abbottsteve/LoRaWAN-ISAC-868MHz/docs/ISAC_868_GitHub_Social_Preview_1280x640.png

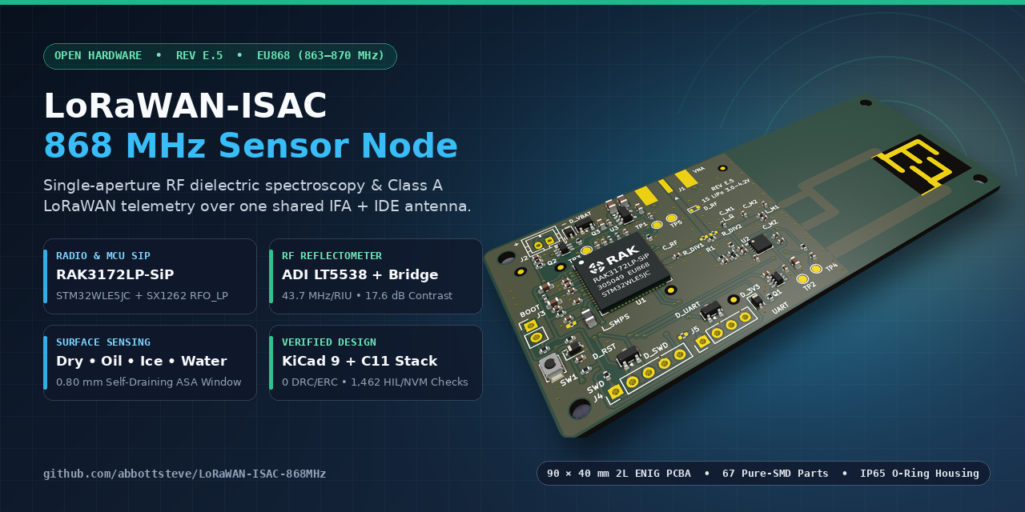
docs/ISAC_868_GitHub_Social_Preview_1280x640.png
