abbottsteve/LoRaWAN-ISAC-868MHz/docs/ISAC_868_System_BoxBuild_BOM.csv

Item | Assembly_Level | Part_Ref | Qty_OptionA_Slim_LiPo | Qty_OptionB_Stepped_LiSOCl2 | Category | Description | Specifications_And_Dimensions | Cold_Temp_Rating | Realistic_Field_Runtime | MPN | Manufacturer | Primary_Sourcing | Verified_Alternates | Assembly_And_Polarity_Notes
1 | Sub-Assembly | PCBA-01 | 1 | 1 | 100% Pure-SMD PCBA | Populated & Tested ISAC 868 MHz Rev E.5 Pure-SMD PCBA | 90.0 x 40.0 x 1.60 mm (+0.03/-0.10 mm), 2L FR-4 IPC-4552 ENIG (2-3 uin Au), Green LPI (>= 0.10 mm dams), 67 populated pure-SMD refs on ISAC_868_Turnkey_CPL_Top.csv (0 THT parts) + 10 DNP refs (J1/J2/J3/J4/J5/C_SMPS3/D_RF/R_DIV1/R_DIV2/R_VUART) per fab/bom/ISAC_868_Turnkey_BOM.csv | -40 C to +85 C | N/A (1.74 uA STOP2 sleep) | ISAC-868-PCBA-REVE5 | PCBWay Turnkey | fab/ISAC_868_RevE5_PCBWay_Turnkey.zip | JLCPCB / MacroFab Turnkey PCBA | J2 is DNP on the sealed field SKU: solder 24-26 AWG silicone battery leads directly from B.Cu (-1.60 mm) upward into J2 bare-ENIG PTH barrels: Pad 1 Square (East @ X_gbr=10.90, Y_gbr=36.15, '-' on F.SilkS & B.SilkS) = BLACK (GND), Pad 2 Round (West @ X_gbr=8.90, '+' on F.SilkS & B.SilkS) = RED (+VBAT_RAW 3.0-4.2V 1S LiPo / 3.6V Li-SOCl2 [4.35V DC MAX; NO 5V PSU]); Q3 = AO3401A ideal-diode PMOS RPP (< 6 mV drop). Factory program & 2-point calibrate via bare ENIG pogo pads on J3/J4/J5 before lid closure.
2 | Box-Build (Option A) | BAT1-OPTA-LIPO | 1 | 0 | Option A Battery (Slim Base Tray) | 302535 (or 352535) 3.7 V 300 mAh Low-Temp LiPo Pouch w/ PCM & 26 AWG Silicone Wire Leads | 3.0 x 25.0 x 35.0 mm (leaves 1.06 mm Z margin above 0.50 mm VHB inside 36.0 x 25.8 x 4.56 mm pocket; 352535 3.5 x 25.0 x 35.0 mm leaves 0.56 mm Z margin) | -20 C (standard LiPo) / -40 C (Grepow LT-LiPo) | ~2.5-3.5 years (limited by LiPo self-discharge; ~6 yrs raw Coulombic @ 4.5 uA avg) | GRP302535-3.7V-300mAh-LT | Grepow | Grepow / Authorized LiPo Distributor | PKCELL LP352535 (3.5x25x35 mm 350mAh); EEMB LP302535 (3.0x25x35 mm 250-300mAh); Adafruit 1S LiPo (trim plug one wire at a time!) | DIRECT SOLDER TO J2 BARE-ENIG PTH PADS (cut factory plug ONE WIRE AT A TIME to prevent shorting!): Pad 1 Square (East @ X_gbr=10.90, '-') = BLACK (GND), Pad 2 Round (West @ X_gbr=8.90, '+') = RED (+VBAT_RAW); Q3 AO3401A blocks reverse current safely.
3 | Box-Build (Option B) | BAT1-OPTB-LISOCL2 | 0 | 1 | Option B Battery (10-Year Sub-Zero Field Base Tray) | 2/3 AA 3.6 V 1300 mAh Spiral-Wound High-Pulse Li-SOCl2 Cell w/ Insulated Wire Leads | Dia 14.5 x 33.5 mm; 3.6 V nominal; 150 mA cont / 300 mA pulse; <1%/yr self-discharge; UN38.3 certified | -55 C to +85 C | 10+ years (~26 yrs Coulombic @ 15-min SF7; <1%/yr self-discharge) | ER14335M/W | Fanso | Authorized Battery Distributor / Fanso / Mouser | Eve Energy ER14335SPC (1300 mAh spiral); Tadiran TLP-93111 / TLH-5955; Saft LS 14250 (1/2 AA w/ foam spacer) | PRIMARY 10-YR SUB-ZERO ICE/FROST CELL (Q3 AO3401A ideal-diode RPP + VBAT-fed Q1 TPS22919DCKR + 104 uF bulk bank sustains LT5538 >= 3.00 V and 3.0V TCXO down to -40 C). Nests in 38.8 x 15.2 x 15.5 mm cradle (X=8.6..47.4 < 50 mm); solder leads directly to J2 from B.Cu. NON-RECHARGEABLE; ship per UN38.3.
4 | Box-Build | STR-RTV-3145 | 1 | 1 | Direct-Solder Wire Strain Relief | Neutral-Cure (Alkoxy) Electronics-Grade RTV Silicone Adhesive + 24-26 AWG Silicone Service-Loop Sleeving | Non-corrosive MIL-A-46146 neutral-cure RTV silicone (NEVER acetic-acid cure!) applied at B.Cu J2 wire exit; 55-65 mm 26 AWG silicone wire service loop routed in -6.16 mm under-PCB relief channel (X=7.4..15.0, Y=31.5..37.65 mm) | -55 C to +200 C | 10+ years | DOWSIL-3145-CLEAR | Dow | DigiKey / Mouser / Authorized Distributor | Momentive RTV162 (MIL-A-46146); Henkel Loctite SI 595CL neutral-cure; 3M Scotch-Weld DP100 | Insert stripped/tinned leads upward from B.Cu (-1.60 mm) into J2 Ø0.75 mm PTH barrels (Pad 1 Square=BLACK GND, Pad 2 Round=RED +VBAT_RAW), solder per IPC-A-610 Class 3 (>=75% barrel fill, trim top fillet <= +1.5 mm), and anchor lead insulation to B.Cu mask with neutral-cure RTV.
5 | Box-Build | PAD-VHB | 1 | 1 | Battery Retention Tape | Die-Cut Double-Sided Acrylic Foam Mounting Strip | 12.0 x 30.0 x 0.50 mm, viscoelastic shock/vibration damper, 100% non-metallic | -40 C to +90 C | 10+ years | VHB-4905-12X30 | 3M | DigiKey / Mouser / McMaster-Carr | 3M VHB 5925 (0.64 mm black); Tesa ACXplus 7063 | Adhere Option A LiPo or Option B ER14335M inside X < 49 mm pocket/cradle so zero rattle occurs; NEVER place foam tape or wires in X >= 50 mm antenna bay.
6 | Box-Build | ADH-WIN-467MP | 1 | 1 | Sensing Window Optical/RF Bond | Void-Free 25 um High-Performance Acrylic Transfer Adhesive Die-Cut Preform | 12.00 x 12.55 x 0.025 mm (25 um / 1.0 mil 200MP acrylic), er ~ 2.8, zero carrier film | -40 C to +149 C | 10+ years | 467MP-12X12.55 | 3M | DigiKey / Mouser / 3M Preferred Converter | 3M 468MP (50 um); Tesa 4972 (48 um) | Bond 0.80 mm ASA/PETG open-East sensing window boss (X=74.60..86.60, Y=7.65..20.20 mm) directly onto bare-ENIG AE1 comb inside continuous [73.40..87.80]x[6.65..20.80] mm F.Mask opening with roller pressure to guarantee 0.000 mm air gap across -40..+85 C.
7 | Box-Build | ENC-LID | 1 | 1 | 3D-Printed Uniform-Flat Waterproof Lid | 100% Uniform-Flat-Roof Waterproof Upper Lid (z_top = +8.50 mm) w/ Open-East Self-Draining 0.80 mm UV-Stabilized ASA Sensing Deck & Compliant -1.44 mm Face-Seal Skirt | 95.7 x 45.7 x 9.94 mm uniform height (z = -1.44..+8.50 mm; zero connector domes or PCB-bay roof slots; 4 corner M2.5 shafts sealed by captive EPDM washers); UV-stabilized ASA (outdoor default, Tg ~ 105 C; indoor alt: PETG, Tg ~ 82 C — NEVER PLA) + clear UV-acrylic / polyurethane conformal seal coat; 0.16 mm layers (5 concentric solid layers = 0.80 mm window); 0.00 mm East dam lip | -40 C to +85 C (ASA) | 10+ years | ISAC_868_Lid_0p80mm_Window.stl | Custom CAD (gen_enclosure.py) | PCBWay 3D Printing (UV-Stabilized ASA / MJF PA12) / In-House FDM | Polymaker PolyLite ASA; HP MJF PA12 w/ Vapor-Smooth Seal; Prusament ASA | Shared 100% uniform flat waterproof upper lid for BOTH Option A and Option B! Zero PCB-bay roof slots or connector bumps (J1..J5 all DNP); +0.16 mm compliant skirt gap prevents FR-4 thickness tolerance hard-stop; open-East self-draining 0.80 mm runoff deck across X=74.60..92.85 mm eliminates stagnant rain/meltwater pooling. Verify 0.80 +/- 0.02 mm window thickness with micrometer.
8 | Box-Build (Option A) | ENC-BASE-OPTA | 1 | 0 | Option A Slim Base Tray | Symmetric Slim Base Tray w/ Continuous 360-Deg 1.80x0.76 mm Parker ORD 5700 O-Ring Groove, Under-PCB J2 Wire Relief & 302535/352535 LiPo Pocket | 95.7 x 45.7 x 6.0 mm (16.10 mm uniform closed enclosure height!); UV-stabilized ASA / MJF PA12; 36.0 x 25.8 x 4.56 mm LiPo pocket + -6.16 mm J2 wire-relief channel + 4.00 mm unloaded IFA air cavity | -40 C to +85 C (ASA) | 10+ years | ISAC_868_Base_Tray.stl | Custom CAD (gen_enclosure.py) | PCBWay 3D Printing (UV-Stabilized ASA / MJF PA12) / In-House FDM | Polymaker PolyLite ASA; HP MJF PA12; Prusament ASA / PETG | OPTION A SLIM TRAY. Symmetric 360-deg unbroken 1.80 x 0.76 mm Parker face-seal O-ring groove (+0.16 mm compliant lid gap = 0.92 mm compressed gland: 23.3% squeeze, 68.3% <= 85% nominal fill, 82.7% <= 85% at 1.44 mm thin PCB); positively locates 302535/352535 LiPo and routes soldered leads underneath B.Cu inside X < 50 mm.
9 | Box-Build (Option B) | ENC-BASE-OPTB | 0 | 1 | Option B Stepped Field Base Tray | Symmetric Stepped Dual-Fit Field Battery-Bay Base Tray w/ Continuous 360-Deg 1.80x0.76 mm Parker O-Ring Groove (2/3 AA ER14335M + 302535 Shelves) | 95.7 x 45.7 x 17.5 mm (total closed node = 27.60 mm over battery pod, 16.10 mm uniform flat over electronics & antenna); UV-stabilized ASA / MJF PA12; 38.8 x 15.2 x 15.5 mm 2/3 AA cradle under X < 50 mm | -40 C to +85 C (ASA) | 10+ years | ISAC_868_Base_Tray_Battery.stl | Custom CAD (gen_enclosure.py) | PCBWay 3D Printing (UV-Stabilized ASA / MJF PA12) / In-House FDM | Polymaker PolyLite ASA; HP MJF PA12; Prusament ASA / PETG | OPTION B OUTDOOR TRAY. Cradles 2/3 AA ER14335M (or 302535/352535 LiPo on -6.16 mm shelves) while keeping 4.00 mm unloaded air pocket under 866.5 MHz IFA.
10 | Box-Build | HW-SCR-M25 | 4 | 4 | Non-Metallic Fasteners | Nylon 6/6 Pan-Head Phillips Machine Screw, M2.5 x 22 mm | M2.5 x 0.45 mm thread, 22.0 mm length, Polyamide 6.6 (PA66), 100% non-magnetic / RF-transparent (fits Dia 2.70 mm ISO 273 medium-fit H1..H4; +2.30 mm full nut thread engagement across 16.10 mm shell + 2x0.80 mm EPDM washers + 2.00 mm nut) | -40 C to +85 C | 10+ years | 9652522 | Wurth Elektronik / Keystone | DigiKey RPC2065-ND / Mouser / McMaster 93805A110 | Keystone 29319; Essentra M2.5x22 PA66; Bossard BN 13260 | Identical M2.5 x 22 mm screw length for BOTH Option A and Option B (+2.30 mm full nut thread protrusion beyond 2.0 mm ISO 4032 nut)! Mandatory non-metallic Nylon inside 40x40 mm antenna aperture.
11 | Box-Build | HW-WSH-M25-SEAL | 8 | 8 | Fastener Weather Sealing Washers | Captive EPDM / Nylon 6/6 Sealing Washer for M2.5 Screw Head & Nut | ID 2.6 mm x OD 5.5 mm x 0.8 mm Shore 60A EPDM / PA66 sealing washer | -40 C to +110 C | 10+ years | 95620A112 | McMaster-Carr / Essentra | McMaster 95620A112 / DigiKey / Mouser | Essentra Sealing Washer M2.5; Bulte EPDM-M2.5 | Install under all 4x M2.5 screw heads on lid exterior and 4x M2.5 hex nuts on base underside to weather-seal the corner clamping shafts.
12 | Box-Build | HW-NUT-M25 | 4 | 4 | Non-Metallic Fasteners | Nylon 6/6 Hex Nut, M2.5 (ISO 4032 / DIN 934) | M2.5 x 0.45 mm, 5.0 mm across flats, 2.0 mm height, Polyamide 6.6 (PA66) | -40 C to +85 C | 10+ years | 4702 | Keystone Electronics | DigiKey 36-4702-ND / Mouser 534-4702 | Wurth 93425; Essentra DIN934-M2.5-PA66 | Clears stepped battery pod wall on Option B (3.10 mm clearance > 2.89 mm nut corner radius) and sits flat on Option A.
13 | Box-Build | SEAL-ORING-EPDM | 1 | 1 | Continuous 360-Deg Perimeter Face-Seal | Closed-Loop Shore 50A Silicone / EPDM O-Ring (or Spliced Vulcanized Cord, 272 mm Perimeter) | Dia 1.20 mm cross-section Shore 50A Silicone / EPDM seated in continuous symmetric 1.80 x 0.76 mm Parker ORD 5700 static face-seal groove (+0.16 mm compliant lid gap = 0.92 mm gland: 23.3% vertical squeeze, 68.3% <= 85% nominal fill, 82.7% <= 85% at 1.44 mm thin PCB) | -55 C to +120 C | 10+ years | OR-SIL-1.20X86-50A | Parker / McMaster-Carr | McMaster 1187N11 / Parker Hannifin / Mouser | Parker S0604-50; Trelleborg EPDM 1.20 mm vulcanized loop | Seat continuous 360-deg loop into unbroken 1.80 x 0.76 mm base perimeter groove before torquing 4x M2.5 x 22 mm Nylon screws onto EPDM sealing washers.
14 | Bench-Optional | CAP-SMA-01 | 0 | 0 | Optional Bare-Board Bench VNA Dust Cap | Silicone / Gasketed Protective Dust Cap for Optional Bench J1 SMA Port (J1 is DNP on Enclosed Field SKU) | 1/4-36 UNS-2B female SMA cap w/ internal silicone O-ring (used only on un-enclosed bench VNA bring-up boards with J1 populated) | -55 C to +125 C | 10+ years | 132357 | Amphenol RF | DigiKey ARF1327-ND / Mouser 523-132357 | Cinch Connectivity 142-0901-901; Linx/TE CONCAP-SMA | Bench bare-PCBA VNA bring-up option only; enclosed Rev E.5 field units leave J1/J2/J3/J4/J5 DNP under the unbroken uniform-flat waterproof shell.
