abbottsteve/LoRaWAN-ISAC-868MHz/fab/bom/ISAC_868_Turnkey_BOM.csv

Item | Designators | Qty | Value | Footprint | MPN | Manufacturer | LCSC | Alternates | DNP
1 | C_BAT, C_CAPM, C_CAPP, C_INN | 4 | 1n | Capacitor_SMD:C_0402_1005Metric | GRM1555C1H102JA01D | Murata | C76947 | Samsung CL05C102JB5NNNC (C1523); Yageo CC0402JRNPO9BN102 | No
2 | C_BLK, C_RF | 2 | 100p | Capacitor_SMD:C_0402_1005Metric | GJM1555C1H101JB01D | Murata | Authorized: DigiKey/Mouser | Murata GRM1555C1H101JA01D; Samsung CL05C101JB5NNNC | No
3 | C_BULK1, C_BULK2 | 2 | 47u | Capacitor_SMD:C_0805_2012Metric | GRM21BR61A476ME15L | Murata | C124129 | Samsung CL21A476MQYNNNE; Taiyo Yuden LMK212BBJ476MG-T | No
4 | C_DET1, C_IN2, C_LPF, C_OUT2, C_Q1, C_RST, C_U1B, C_U1C, C_VREF | 9 | 100n | Capacitor_SMD:C_0402_1005Metric | GRM155R71C104KA88D | Murata | C71629 | Samsung CL05B104KO5NNNC (C1525); Yageo CC0402KRX7R7BB104 | No
5 | C_DET2, C_OUT1 | 2 | 1u | Capacitor_SMD:C_0603_1608Metric | GRM188R71E105KA12D | Murata | C86020 | Samsung CL10B105KA8NNNC; Yageo CC0603KRX7R8BB105 | No
6 | C_IN1 | 1 | 10u | Capacitor_SMD:C_0603_1608Metric | GRM188R61E106MA73D | Murata | C91606 | Samsung CL10A106MA8NRNC; Murata GRM188R61E106KA73D | No
7 | C_M1 | 1 | 3.6p | Capacitor_SMD:C_0402_1005Metric | GJM1555C1H3R6WB01D | Murata | Authorized: DigiKey/Mouser | Murata GJM1555C1H3R6BB01D (C94175); Johanson 500R07S3R6BV4T | No
8 | C_M2 | 1 | 4.3p | Capacitor_SMD:C_0402_1005Metric | GJM1555C1H4R3WB01D | Murata | Authorized: DigiKey/Mouser | Murata GJM1555C1H4R3BB01D (C94181); Johanson 500R07S4R3BV4T | No
9 | C_MZ | 1 | 0.5p | Capacitor_SMD:C_0402_1005Metric | GJM1555C1HR50WB01D | Murata | Authorized: DigiKey/Mouser | Murata GJM1555C1HR50BB01D (C181064); Johanson 500R07SR50BV4T | No
10 | C_PAV, C_RFV, C_VBAT, C_VDDA2 | 4 | 1u | Capacitor_SMD:C_0402_1005Metric | GRM155R61E105KA12D | Murata | C77009 | Samsung CL05A105KA5NQNC; Taiyo Yuden TMK105BJ105KV-F | No
11 | C_S, C_S2 | 2 | 1.0p | Capacitor_SMD:C_0402_1005Metric | GJM1555C1H1R0WB01D | Murata | C161339 | Murata GRM1555C1H1R0WA01D; Johanson 500R07S1R0AV4T | No
12 | C_SMPS1 | 1 | 4.7u | Capacitor_SMD:C_0402_1005Metric | GRM155R61A475MEAAD | Murata | C335105 | Samsung CL05A475MP5NRNC; Taiyo Yuden LMK105BJ475MV-F | No
13 | C_SMPS2 | 1 | 470n | Capacitor_SMD:C_0402_1005Metric | GRM155R71C474KA01D | Murata | C52923 | Samsung CL05B474KO5NNNC (C1621); Taiyo Yuden TMK105B7474KVHF | No
14 | C_U1A, C_VDDA1 | 2 | 4.7u | Capacitor_SMD:C_0603_1608Metric | GRM188R61E475KE11D | Murata | C90057 | Samsung CL10A475KA8NNNC; Taiyo Yuden TMK107BJ475KA-T | No
15 | D_3V3, D_RST, D_VBAT | 3 | PESD5V0S1BA | Diode_SMD:D_SOD-323 | PESD5V0S1BA,115 | Nexperia | C19224 | Nexperia PESD5V0L1BA,115 (C15847, I_RM<=50nA, SOD-323 bidir); Bourns CDSOD323-T05C (SOD-323 bidir) | No
16 | D_SWD, D_UART | 2 | PESD5V0U2BT | Package_TO_SOT_SMD:SOT-23 | PESD5V0U2BT,215 | Nexperia | Authorized: DigiKey/Mouser | Nexperia PESD5V0L2BT,215 (C15855); TI TPD2E009DBZR; ST ESDA6V1L (SOT-23 3-pin 1=IO1,2=IO2,3=GND) | No
17 | FB_PA, FB_RF, FB_VDDA | 3 | 120R@100M | Inductor_SMD:L_0402_1005Metric | BLM15AG121SN1D | Murata | C85812 | TDK MMZ1005S121CT000; Taiyo Yuden BK1005HS121-T | No
18 | FB_SMPS | 1 | 0R | Resistor_SMD:R_0402_1005Metric | RC0402JR-070RL | Yageo | C60485 | Uni-Royal 0402WGF0000TCE; Panasonic ERJ-2GE0R00X | No
19 | L_M1 | 1 | 8.2n | Inductor_SMD:L_0402_1005Metric | LQW15AN8N2G00D | Murata | Authorized: DigiKey/Mouser | Coilcraft 0402CS-8N2XGLW; Taiyo Yuden HKQ1005S8N2S-T | No
20 | L_Q | 1 | 27n | Inductor_SMD:L_0402_1005Metric | LQW15AN27NG00D | Murata | Authorized: DigiKey/Mouser | Coilcraft 0402CS-27NXGLW; Murata LQW15AN27NG80D | No
21 | L_S | 1 | 30n | Inductor_SMD:L_0402_1005Metric | LQW15AN30NG00D | Murata | Authorized: DigiKey/Mouser | Coilcraft 0402CS-30NXGLW; Murata LQW15AN30NG80D | No
22 | L_SMPS | 1 | 15u | Inductor_SMD:L_0805_2012Metric | LQH2MCN150K02L | Murata | C86089 | Murata LQM21PN150MGH (0805 15uH power inductor, Isat=300mA); TDK VLS201610HBX-150M-1 -- NEVER substitute ferrite EMI beads (MLZ2012) | No
23 | Q1 | 1 | TPS22919DCKR | Package_TO_SOT_SMD:SOT-363_SC-70-6 | TPS22919DCKR | Texas Instruments | Authorized: DigiKey/Mouser | NO SUBSTITUTION -- TI TPS22919DCKR / TPS22919QDCKRQ1 (SC-70-6 DCK pinout 1=VIN,2=GND,3=ON,4=NC,5=QOD,6=VOUT) ONLY | No
24 | Q2 | 1 | NX3008CBKS | Package_TO_SOT_SMD:SOT-363_SC-70-6 | NX3008CBKS,115 | Nexperia | C456076 | NO SUBSTITUTION -- Nexperia NX3008CBKS,115 (SOT-363 complementary N+P MOSFET, 1=S1,2=G1,3=D2,4=S2,5=G2,6=D1) ONLY | No
25 | Q3 | 1 | AO3401A | Package_TO_SOT_SMD:SOT-23 | AO3401A | Alpha & Omega | C15127 | Nexperia PMV48XP,215 (C15137); Infineon IRLML6402TRPBF (C2590); Vishay SI2301CDS-T1-GE3 (C10487) | No
26 | R1 | 1 | 8.2 (0.1%) | Resistor_SMD:R_0402_1005Metric | RT0402BRD078R2L | Yageo | Authorized: DigiKey/Mouser | Yageo RT0402DRD078R2L (±0.5%); Panasonic ERA-2AED8R2X (±0.5%) | No
27 | R2 | 1 | 681 (0.1%) | Resistor_SMD:R_0402_1005Metric | RG1005P-6810-B-T5 | Susumu | Authorized: DigiKey/Mouser | Vishay TNPW0402681RBEED; Yageo RT0402BRD07681RL | No
28 | R3 | 1 | 3.57k (0.1%) | Resistor_SMD:R_0402_1005Metric | RG1005P-3571-B-T5 | Susumu | Authorized: DigiKey/Mouser | Vishay TNPW04023K57BEED; Yageo RT0402BRD073K57L | No
29 | R_B1, R_B2 | 2 | 4.7k (0.1%) | Resistor_SMD:R_0402_1005Metric | RG1005P-472-B-T5 | Susumu | Authorized: DigiKey/Mouser | Vishay TNPW04024K70BEED; Yageo RT0402BRD074K7L | No
30 | R_BG | 1 | 470k | Resistor_SMD:R_0402_1005Metric | RC0402FR-07470KL | Yageo | C482181 | Uni-Royal 0402WGF4703TCE; Vishay CRCW0402470KFKED | No
31 | R_BHI, R_BOOT, R_RST | 3 | 10k | Resistor_SMD:R_0402_1005Metric | RC0402FR-0710KL | Yageo | C60490 | Uni-Royal 0402WGF1002TCE; Vishay CRCW040210K0FKED | No
32 | R_BPD, R_PD | 2 | 100k | Resistor_SMD:R_0402_1005Metric | RC0402FR-07100KL | Yageo | C60491 | Uni-Royal 0402WGF1003TCE; Vishay CRCW0402100KFKED | No
33 | R_LPF, R_VAPP | 2 | 1k | Resistor_SMD:R_0402_1005Metric | RC0402FR-071KL | Yageo | C106235 | Uni-Royal 0402WGF1001TCE; Vishay CRCW04021K00FKED | No
34 | R_TERM | 1 | 56 (0.1%) | Resistor_SMD:R_0402_1005Metric | RG1005P-560-B-T5 | Susumu | Authorized: DigiKey/Mouser | Vishay TNPW040256R0BEED; Yageo RT0402BRD0756RL | No
35 | SW1 | 1 | RESET | Button_Switch_SMD:SW_SPST_B3U-1000P | B3U-1000P | Omron | C231329 | Omron B3U-1000P-B (exact 3.0x2.5mm 2-pad SPST SMD land pattern) | No
36 | U1 | 1 | RAK3172LP-SiP | ISAC:RAK3172LP-SiP_LGA-73_12x12mm_P0.6mm | RAK3172LP-SIP-8-SM-NI | RAKwireless | Authorized: RAKwireless/Mouser/DigiKey | NO SUBSTITUTION -- Authorized RAKwireless SKU 305049 / Mouser 910-RAK3172LPSIP8SMN / DigiKey ONLY (EU868 RFO_LP LGA-73; DO NOT substitute RAK3172-SiP RFO_HP) | No
37 | U2 | 1 | LT5538IDD#TRPBF | ISAC:LT5538IDD_DFN-8-1EP_3x3mm_P0.5mm_EP1.65x2.38mm | LT5538IDD#TRPBF | Analog Devices | Authorized: DigiKey/Mouser | NO SUBSTITUTION -- Analog Devices LT5538IDD#TRPBF (8mm T&R, Mouser 584-LT5538IDD#TRPBF / DigiKey LT5538IDD#TRPBFCT-ND); LT5538IDD#PBF (37-pc tube, LCSC C580201 -- requires custom tube feeder) | No
38 | U3 | 1 | TPS7A0233DBVR | Package_TO_SOT_SMD:SOT-23-5 | TPS7A0233DBVR | Texas Instruments | C2873330 | NO SUBSTITUTION -- TI TPS7A0233DBVR (SOT-23-5 DBV pinout 1=IN,2=GND,3=EN,4=NC,5=OUT, Iq=25nA) ONLY | No
39 | C_SMPS3 | 1 | DNP 100n | ISAC:C_0402_1005Metric_DNP_NoPaste | GRM155R71C104KA88D | Murata | C71629 | Samsung CL05B104KO5NNNC (C1525); Yageo CC0402KRX7R7BB104 | Yes
40 | D_RF | 1 | DNP | ISAC:D_SOD-523_DNP_NoPaste | ESD9B5.0ST5G | onsemi | Authorized: DigiKey/Mouser | Nexperia PESD5V0U1BB,115 (C85364); Vishay VESD05A1B-HAF-GS08 (SOD-523 ultra-low Cd=0.5pF RF ESD) | Yes
41 | J1 | 1 | DNP SMA_VNA | ISAC:SMA_Molex_73251-1153_EdgeMount_Horizontal_HandSolder | 73251-1153 | Molex | Authorized: Mouser/DigiKey | NO SUBSTITUTION -- Molex 73251-1153 (1.60mm PCB edge-straddle SMA jack; DNP on enclosed field SKU, post-reflow hand-solder on bench VNA units) ONLY | Yes
42 | J2 | 1 | DNP 1S_BATT | Connector_JST:JST_PH_B2B-PH-K_1x02_P2.00mm_Vertical | B2B-PH-K-S | JST | C131337 | DNP on sealed field SKU -- solder 24-26 AWG silicone battery leads directly to bare ENIG PTH pads (Pad1 Square=BLACK GND, Pad2 Round=RED +VBAT_RAW); JST B2B-PH-K-S(LF)(SN) (LCSC C54911) optional for bench builds | Yes
43 | J3 | 1 | DNP BOOT | Connector_PinHeader_2.54mm:PinHeader_1x02_P2.54mm_Vertical | PZ254V-11-02P | XFCN | C492401 | Wurth 61300211121; Amphenol 68000-102HLF (DNP on sealed field SKU -- bare ENIG pogo-pin pads) | Yes
44 | J4 | 1 | DNP SWD | Connector_PinHeader_2.54mm:PinHeader_1x05_P2.54mm_Vertical | PZ254V-11-05P | XFCN | C492404 | Wurth 61300511121; Amphenol 68000-105HLF (DNP on sealed field SKU -- bare ENIG pogo-pin pads) | Yes
45 | J5 | 1 | DNP UART | Connector_PinHeader_2.54mm:PinHeader_1x04_P2.54mm_Vertical | PZ254V-11-04P | XFCN | C492403 | Wurth 61300411121; Amphenol 68000-104HLF (DNP on sealed field SKU -- bare ENIG pogo-pin pads) | Yes
46 | R_DIV1, R_DIV2, R_VUART | 3 | DNP 0R | ISAC:R_0402_1005Metric_DNP_NoPaste | RC0402JR-070RL | Yageo | C60485 | Uni-Royal 0402WGF0000TCE; Panasonic ERJ-2GE0R00X | Yes
