abbottsteve/LoRaWAN-ISAC-868MHz/fab/cpl/ISAC_868_Bench_THT_HandSolder.csv

Ref | Val | Package | FieldSKU_DNP | BodyCenter_X_mm | BodyCenter_Y_mm | Pad1_X_mm | Pad1_Y_mm | Rot_deg | AssemblyProcess
J1 | DNP SMA_VNA | SMA_Molex_73251-1153_EdgeMount_Horizontal_HandSolder | Yes | 34.5000 | 36.2675 | 34.5000 | 37.3400 | 270.0000 | DNP_FieldSKU_HandSolder_BenchVNA_PostReflow
J2 | DNP 1S_BATT | JST_PH_B2B-PH-K_1x02_P2.00mm_Vertical | Yes | 9.9000 | 36.1500 | 10.9000 | 36.1500 | 180.0000 | DNP_FieldSKU_DirectSolder_BattLeads_From_B_Cu
J3 | DNP BOOT | PinHeader_1x02_P2.54mm_Vertical | Yes | 2.4000 | 19.2300 | 2.4000 | 20.5000 | 0.0000 | DNP_FieldSKU_BareENIG_PogoPads_PreLid
J4 | DNP SWD | PinHeader_1x05_P2.54mm_Vertical | Yes | 13.5800 | 3.0000 | 8.5000 | 3.0000 | 90.0000 | DNP_FieldSKU_BareENIG_PogoPads_PreLid
J5 | DNP UART | PinHeader_1x04_P2.54mm_Vertical | Yes | 26.3500 | 3.0000 | 22.5400 | 3.0000 | 90.0000 | DNP_FieldSKU_BareENIG_PogoPads_PreLid
