abbottsteve/LoRaWAN-ISAC-868MHz/3dmodels/RAK3172LP-SiP_marking.step

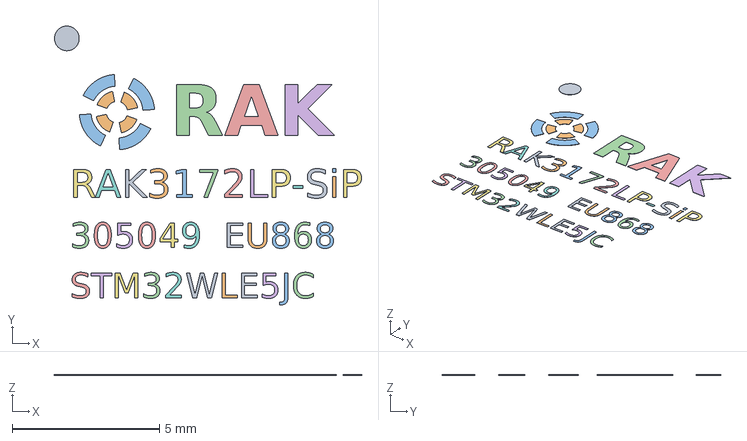
[picture p15: CAD file, 2026-11-07]
3dmodels/RAK3172LP-SiP_marking.step
10.4 x 9.46 x 0.008 mm
