abbottsteve/LoRaWAN-ISAC-868MHz/cst_studio/cad_exports/Counterpoise_B_Cu.dxf

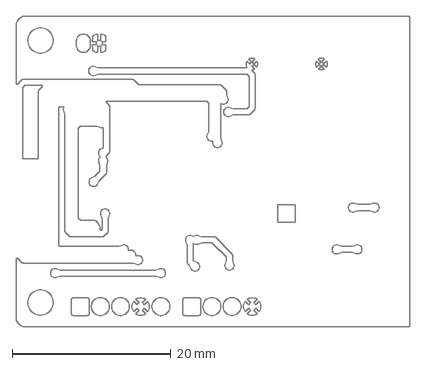
[picture p16: CAD file, 2026-11-07]
cst_studio/cad_exports/Counterpoise_B_Cu.dxf
49.5 x 39.1 mm
