abbottsteve/LoRaWAN-ISAC-868MHz/enclosure/ISAC_868_Lid_0p80mm_Window.stl

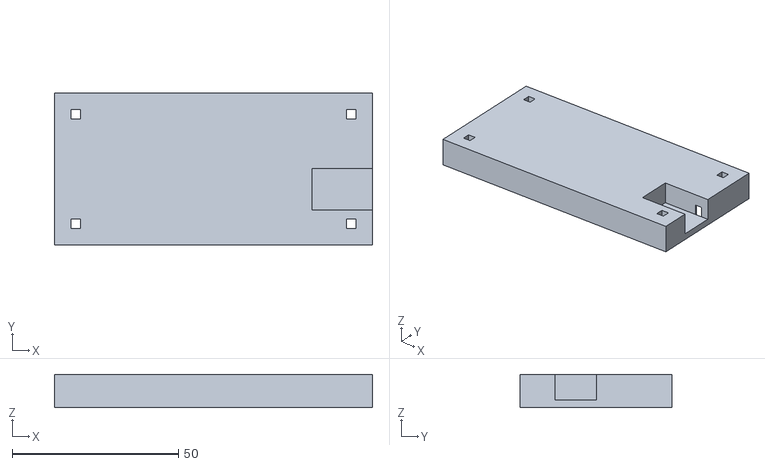
[picture p17: CAD file, 2026-11-07]
enclosure/ISAC_868_Lid_0p80mm_Window.stl
95.7 x 45.7 x 9.94
