abbottsteve/LoRaWAN-ISAC-868MHz/3dmodels/RAK3172LP-SiP.step

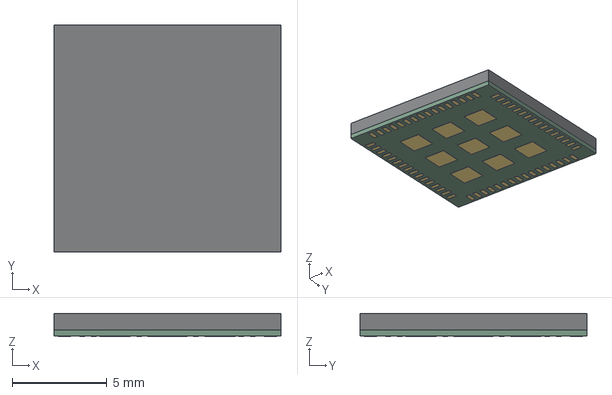
[picture p18: CAD file, 2026-11-07]
3dmodels/RAK3172LP-SiP.step
12.0 x 12.0 x 1.22 mm
