abbottsteve/LoRaWAN-ISAC-868MHz/cst_studio/cad_exports/PCB_Outline_EdgeCuts.dxf

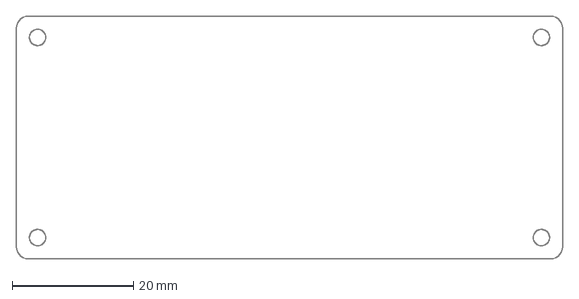
[picture p19: CAD file, 2026-11-07]
cst_studio/cad_exports/PCB_Outline_EdgeCuts.dxf
90.0 x 40.0 mm
