abbottsteve/LoRaWAN-ISAC-868MHz/enclosure/ISAC_868_Base_Tray_Battery.stl

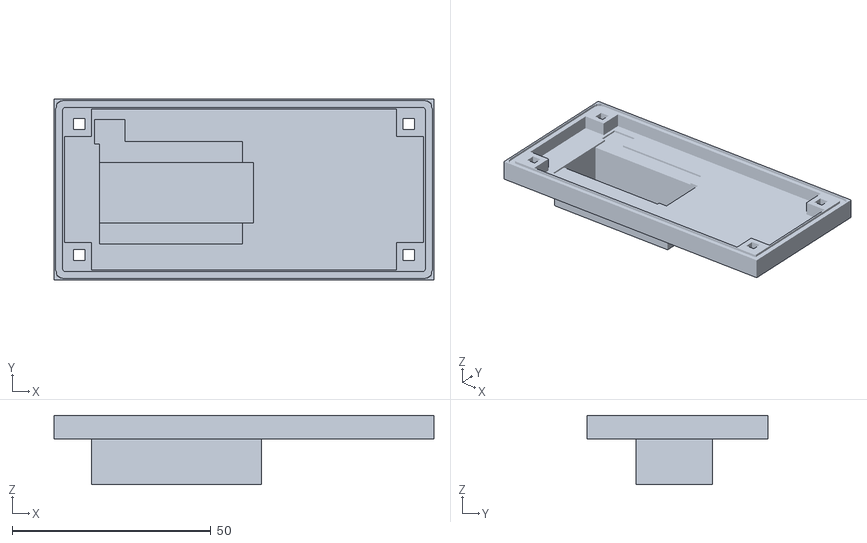
[picture p20: CAD file, 2026-11-07]
enclosure/ISAC_868_Base_Tray_Battery.stl
95.7 x 45.7 x 17.5
