abbottsteve/LoRaWAN-ISAC-868MHz/fab/mechanical/ISAC_868_Base_Tray.stl

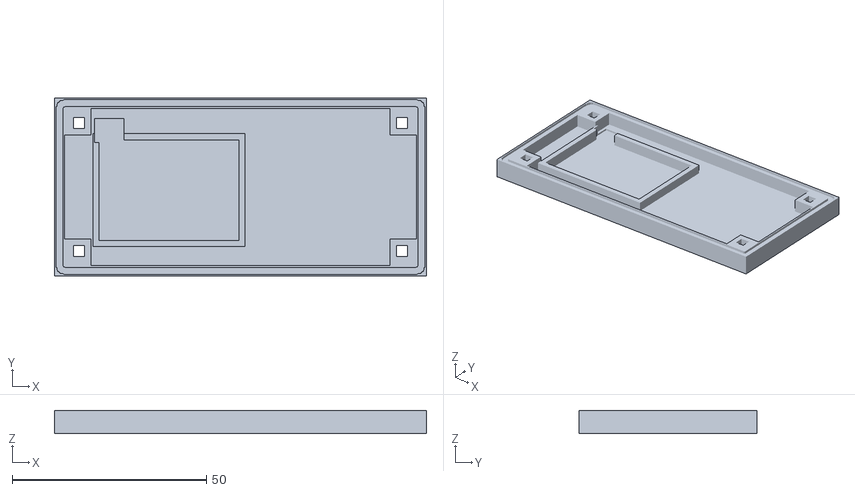
[picture p21: CAD file, 2026-11-07]
fab/mechanical/ISAC_868_Base_Tray.stl
95.7 x 45.7 x 6.00
