abbottsteve/LoRaWAN-ISAC-868MHz/cst_studio/cad_exports/AE1_and_Filter_F_Cu.dxf

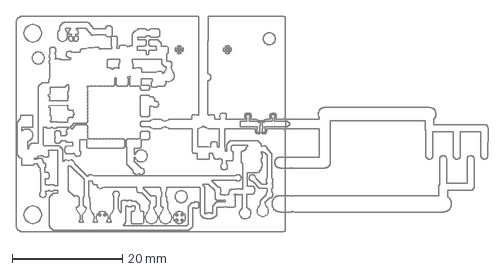
[picture p22: CAD file, 2026-11-07]
cst_studio/cad_exports/AE1_and_Filter_F_Cu.dxf
85.8 x 39.1 mm
