abbottsteve/LoRaWAN-ISAC-868MHz/fab/mechanical/ISAC_868_PCBA.step

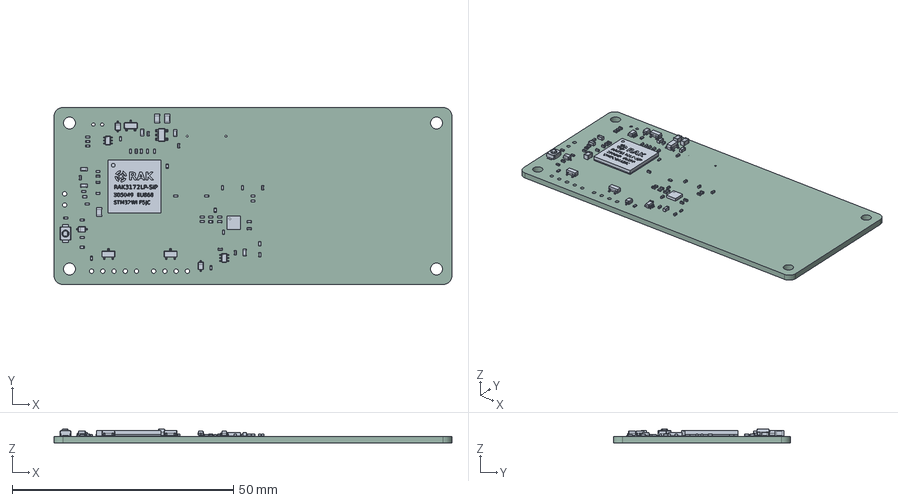
[picture p23: CAD file, 2026-11-07]
fab/mechanical/ISAC_868_PCBA.step
90.0 x 40.0 x 3.20 mm
L_0402_1005Metric x 6
R_0402_1005Metric x 15
SOT-23 x 3
C_0402_1005Metric x 26
RAK3172LP-SiP
RAK3172LP-SiP_marking
L_0805_2012Metric
C_0805_2012Metric x 2
SOT-23-5
SOT-363_SC-70-6 x 2
SW_SPST_B3U-1000P
D_SOD-323 x 3
C_0603_1608Metric x 5
DFN-8-1EP_3x3mm_P0.5mm_EP1.66x2.38mm
ISAC_868_KiCad9_PCB
