abbottsteve/LoRaWAN-ISAC-868MHz/(list of files, cad)

Other CAD files:
cst_studio/cad_exports/Bare_ENIG_Window_F_Mask.dxf
