abbottsteve/LoRaWAN-ISAC-868MHz/docs/reports/u1_pad_verification.csv

Pin | RAK_Datasheet_Name | STM32WLE5JC_Function | Schematic_Net | Vendor_X_mm | Vendor_Y_mm | Vendor_W_mm | Vendor_H_mm | KiCad_X_mm | KiCad_Y_mm | KiCad_W_mm | KiCad_H_mm | Paste_Margin_mm | Max_Abs_Error_mm
1 | PA13 | PA13 / JTMS-SWDIO | SWDIO | -5.65 | -4.5 | 1.17 | 0.37 | -5.65 | -4.5 | 1.17 | 0.37 | -0.035 | 0.0
2 | PA14 | PA14 / JTCK-SWCLK | SWCLK | -5.65 | -3.9 | 1.17 | 0.37 | -5.65 | -3.9 | 1.17 | 0.37 | -0.035 | 0.0
3 | VDD | VDD1 digital supply | 3V3 | -5.65 | -3.3 | 1.17 | 0.37 | -5.65 | -3.3 | 1.17 | 0.37 | -0.035 | 0.0
4 | VBAT | VBAT backup supply | 3V3 | -5.65 | -2.7 | 1.17 | 0.37 | -5.65 | -2.7 | 1.17 | 0.37 | -0.035 | 0.0
5 | PC13 | PC13 GPIO | NC | -5.65 | -2.1 | 1.17 | 0.37 | -5.65 | -2.1 | 1.17 | 0.37 | -0.035 | 0.0
6 | VREF+ | VREF+ ADC positive ref | VDDA | -5.65 | -1.5 | 1.17 | 0.37 | -5.65 | -1.5 | 1.17 | 0.37 | -0.035 | 0.0
7 | VDDA | VDDA analog supply | VDDA | -5.65 | -0.9 | 1.17 | 0.37 | -5.65 | -0.9 | 1.17 | 0.37 | -0.035 | 0.0
8 | PA15 | PA15 / ADC_IN11 (RUI3 A4) | DET_ADC | -5.65 | -0.3 | 1.17 | 0.37 | -5.65 | -0.3 | 1.17 | 0.37 | -0.035 | 0.0
9 | PB15 | PB15 GPIO | NC | -5.65 | 0.3 | 1.17 | 0.37 | -5.65 | 0.3 | 1.17 | 0.37 | -0.035 | 0.0
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
