abbottsteve/LoRaWAN-ISAC-868MHz/cst_studio/results/fdtd_reference/fdtd_touchstone_selfcheck.csv

case | medium | s1p_f0_ant_MHz | fdtd_f0_ant_MHz | s1p_s11_866p5_ant_dB | s1p_s11_866p5_brq_dB | fdtd_s11_866p5_brq_dB | s1p_tilt_dB | fdtd_tilt_dB | s1p_notch_dB | fdtd_notch_dB | s1p_level_dBm | fdtd_level_dBm | classified_state
01_bare_pcb | bare | 940.0 | 940.0 | -0.78 | -1.34 | -1.34 | 0.93 |  | 0.04 |  | -26.87 |  | — (Unenclosed VNA)
02_dry_air | dry air | 869.0 | 869.0 | -23.69 | -20.83 | -20.83 | -3.44 | -3.44 | 4.88 | 4.88 | -45.66 | -45.66 | DRY_AIR
03_enclosed_lipo | lipo | 869.0 | 869.0 | -23.68 | -20.81 | -20.81 | -3.45 |  | 4.86 |  | -45.64 |  | DRY_AIR
04_fr4_low_4p2 | fr4_low | 879.0 | 879.0 | -10.01 | -12.67 | -12.67 | 1.73 |  | 0.61 |  | -36.59 |  | — (FR-4 er=4.2 Corner)
05_fr4_high_4p6 | fr4_high | 859.5 | 859.5 | -14.42 | -12.76 | -12.76 | -4.57 |  | 0.47 |  | -40.06 |  | — (FR-4 er=4.6 Corner)
06_oil_ptfe | PTFE | 849.0 | 849.0 | -7.04 | -7.14 | -7.14 | -1.23 | -1.23 | 0.15 | 0.15 | -33.27 | -33.26 | OIL
07_glaze_ice | glaze ice | 834.5 | 834.5 | -2.55 | -2.89 | -2.89 | -0.01 | -0.01 | 0.06 | 0.06 | -28.63 | -28.63 | GLAZE_ICE
08_alumina_al2o3 | alumina Al2O3 | 783.0 | 783.0 | -0.36 | -0.53 | -0.53 | 1.56 | 1.56 | 0.04 | 0.03 | -26.19 | -26.19 | IPA
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
