abbottsteve/LoRaWAN-ISAC-868MHz/rf/results/bridge_sparam_sweep.csv

freq_MHz | s11_dB | s21_dB | s12_dB | s22_dB | null_50R_dBm | vout_50R_V | directivity_wc_dB
850.0 | -23.733 | -0.801 | -0.801 | -23.936 | -32.005 | 1.079 | 6.267
850.5 | -23.72 | -0.801 | -0.801 | -23.934 | -32.248 | 1.074 | 6.513
851.0 | -23.707 | -0.801 | -0.801 | -23.931 | -32.498 | 1.07 | 6.766
851.5 | -23.694 | -0.801 | -0.801 | -23.929 | -32.756 | 1.065 | 7.027
852.0 | -23.681 | -0.801 | -0.801 | -23.926 | -33.023 | 1.06 | 7.297
852.5 | -23.668 | -0.801 | -0.801 | -23.923 | -33.298 | 1.055 | 7.575
853.0 | -23.654 | -0.801 | -0.801 | -23.92 | -33.584 | 1.049 | 7.864
853.5 | -23.641 | -0.801 | -0.801 | -23.917 | -33.879 | 1.043 | 8.162
854.0 | -23.628 | -0.801 | -0.801 | -23.913 | -34.185 | 1.038 | 8.471
854.5 | -23.614 | -0.801 | -0.801 | -23.91 | -34.504 | 1.032 | 8.792
855.0 | -23.601 | -0.801 | -0.801 | -23.907 | -34.834 | 1.025 | 9.126
855.5 | -23.588 | -0.801 | -0.801 | -23.903 | -35.179 | 1.019 | 9.473
856.0 | -23.574 | -0.801 | -0.801 | -23.899 | -35.538 | 1.012 | 9.835
856.5 | -23.561 | -0.801 | -0.801 | -23.895 | -35.913 | 1.005 | 10.213
857.0 | -23.547 | -0.801 | -0.801 | -23.891 | -36.306 | 0.997 | 10.599
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
