abbottsteve/LoRaWAN-ISAC-868MHz/rf/results/ifa_s11_efficiency.csv

scenario | f_res_MHz | min_s11_dB | worst_s11_863_870_dB | s11_866p5_raw_dB | s11_866p5_dB | bw_minus10dB_MHz | eta_rad_866p5_pct | eta_tot_866p5_pct | eta_tot_866p5_dB | harm_atten_2f0_dB | harm_atten_3f0_dB
1_Bare_PCB_FreeSpace (no lid) | 940.0 | -3.84 | -1.31 | -0.78 | -1.34 | 0.0 | 67.5 | 14.2 | -8.49 | 37.52 | 58.99
2_Enclosed_Nom_0p80mm_ASA (er=4.4, Dry Air) | 869.0 | -32.69 | -17.77 | -23.69 | -20.83 | 24.0 | 50.0 | 45.5 | -3.42 | 37.2 | 60.08
3_Enclosed_With_302535_LiPo_Under_GND | 869.0 | -32.79 | -17.77 | -23.68 | -20.81 | 24.0 | 50.0 | 45.5 | -3.42 | 37.17 | 60.07
4_Enclosed_FR4_Low_er4p2 | 879.0 | -34.19 | -10.21 | -10.01 | -12.67 | 24.5 | 47.5 | 40.4 | -3.94 | 37.2 | 60.04
5_Enclosed_FR4_High_er4p6 | 859.5 | -31.06 | -10.3 | -14.42 | -12.76 | 24.0 | 49.3 | 43.6 | -3.6 | 37.19 | 60.12
6_PTFE_Oil_on_0p80mm_Window (eps*=2.1-j0.0002) | 849.0 | -29.33 | -5.82 | -7.04 | -7.14 | 24.0 | 46.5 | 35.4 | -4.51 | 37.24 | 60.28
7_Glaze_Ice_on_0p80mm_Window (eps*=3.2-j0.003) | 834.5 | -26.91 | -2.23 | -2.55 | -2.89 | 23.5 | 29.0 | 13.4 | -8.71 | 37.26 | 60.33
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
