abbottsteve/LoRaWAN-ISAC-868MHz/docs/ISAC_868_Schematic.pdf

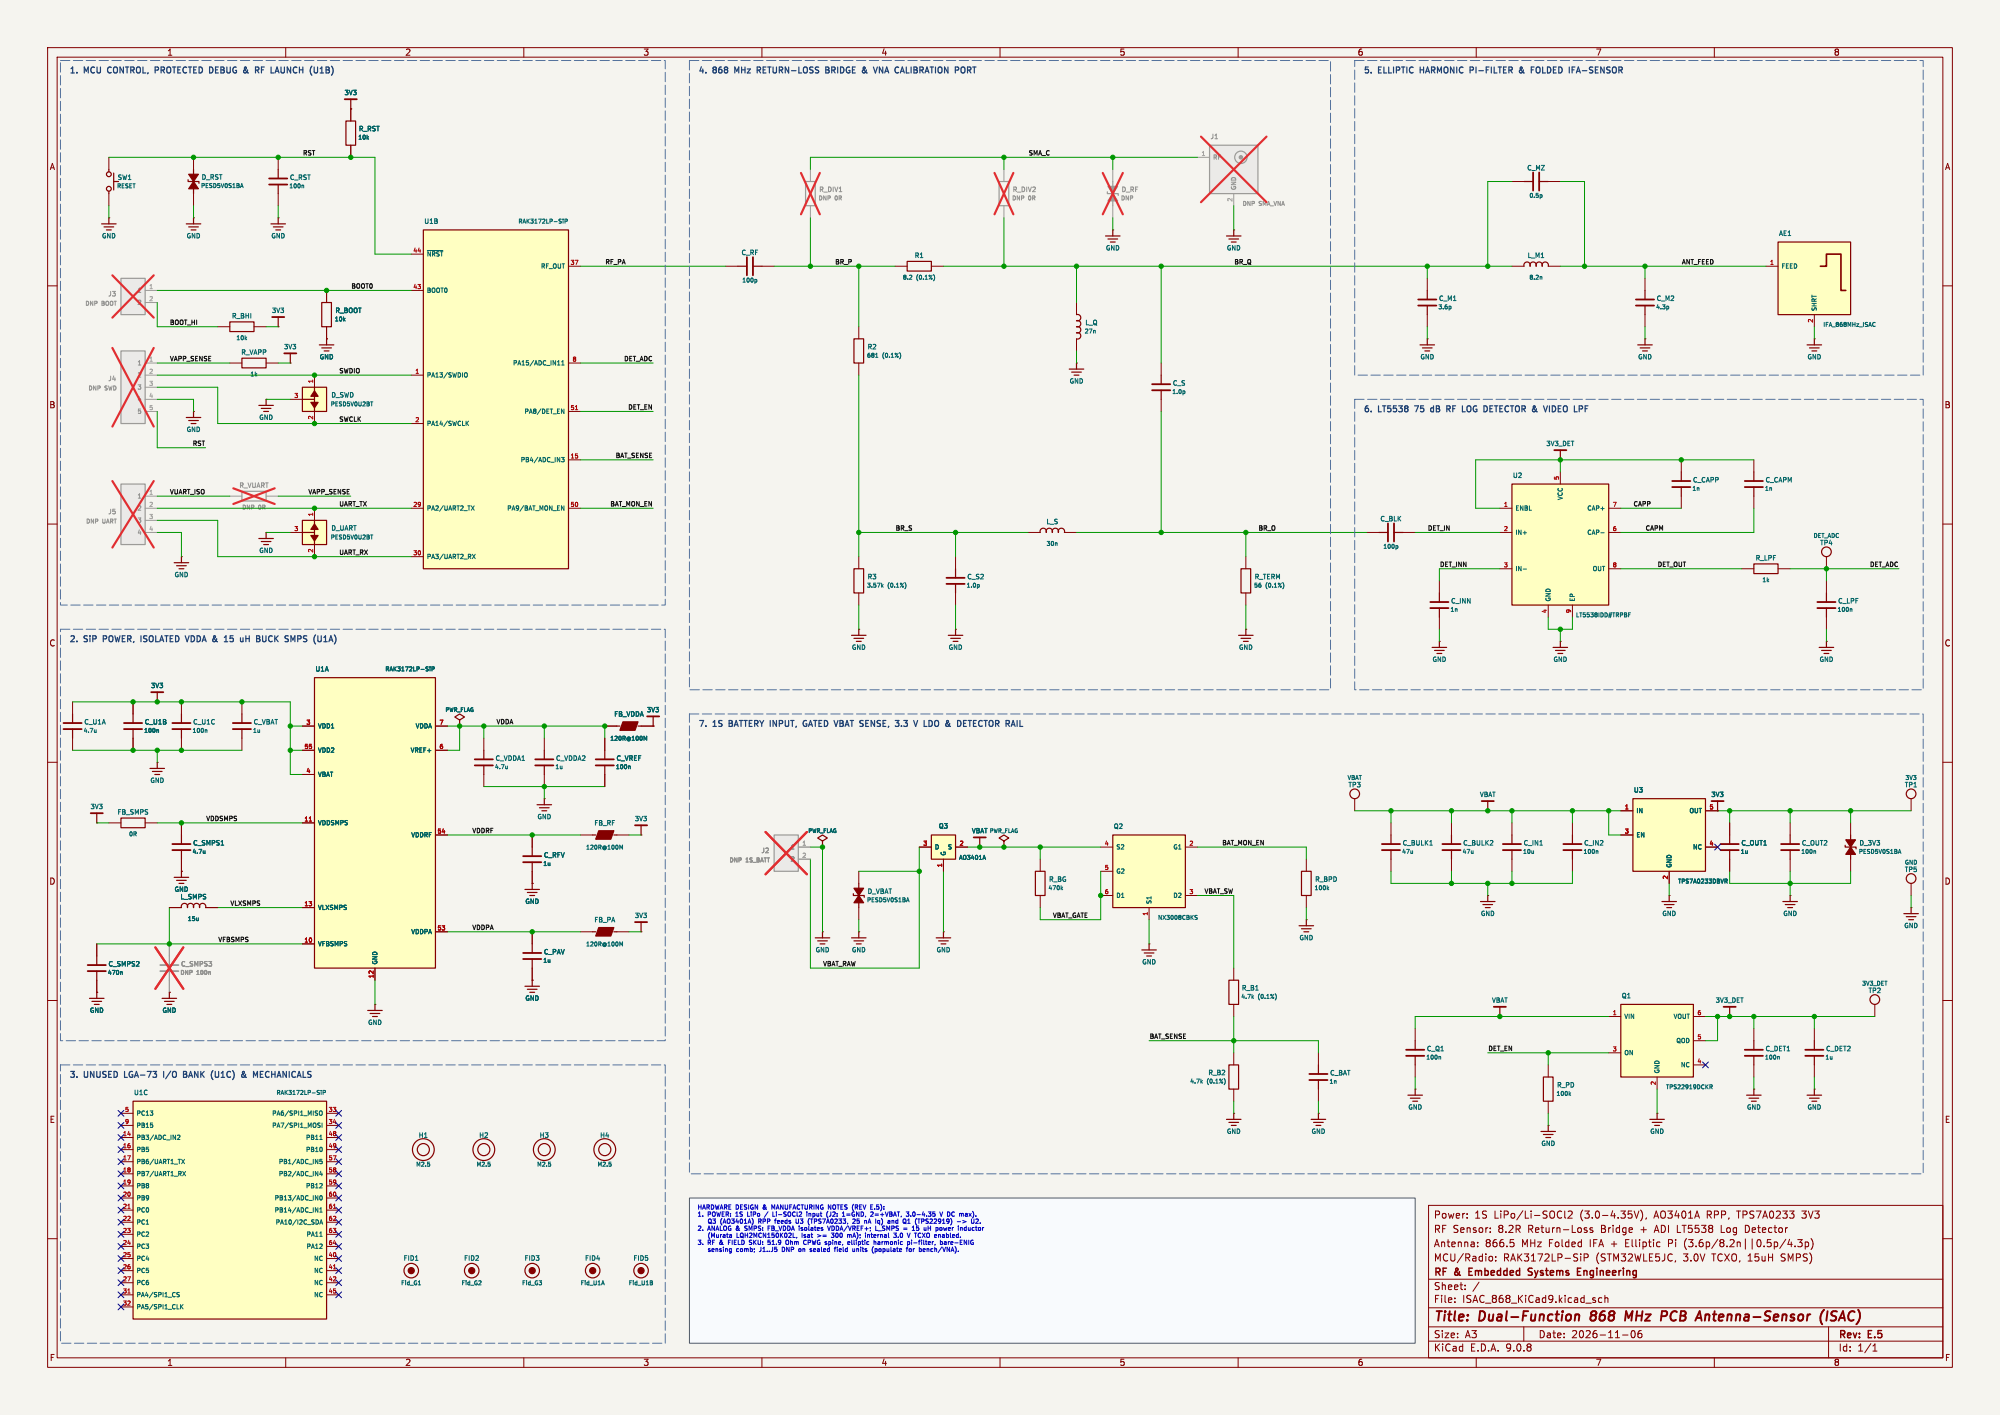
[picture p27: page 1]

4. 868 MHz RETURN-LOSS BRIDGE & VNA CALIBRATION PORT

6. LT5538 75 dB RF LOG DETECTOR & VIDEO LPF
