abbottsteve/LoRaWAN-ISAC-868MHz/docs/ISAC_868_Assembly_Top.pdf

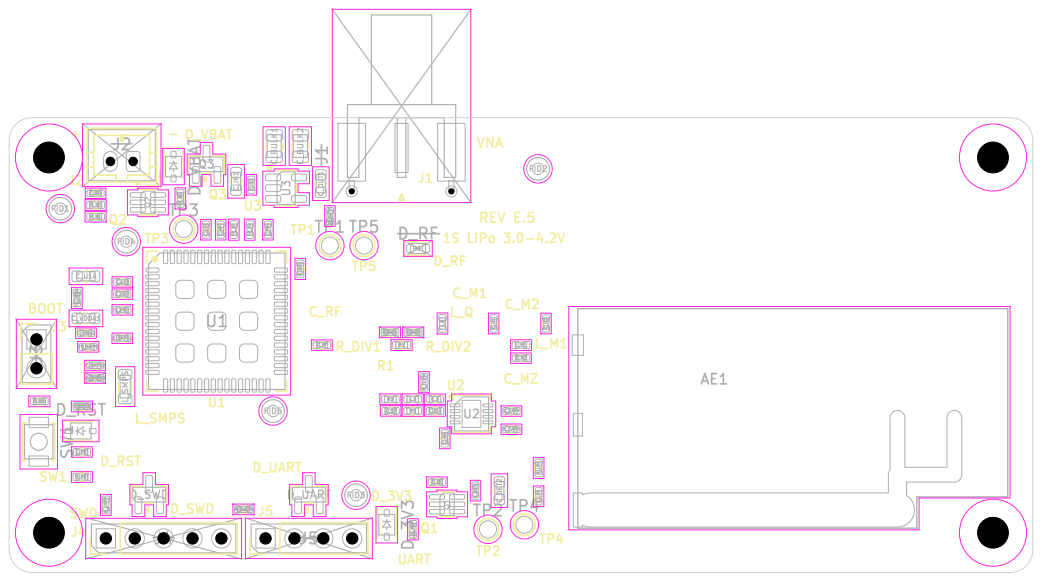
[picture p28: page 1]
