abbottsteve/LoRaWAN-ISAC-868MHz/docs/ISAC_868_PCB_Bottom_Sheet.pdf

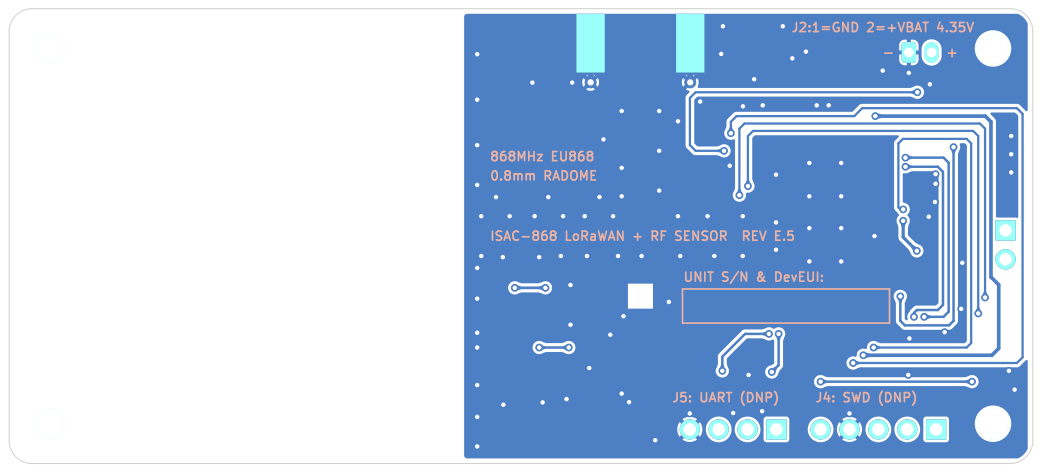
[picture p29: page 1]
