abbottsteve/LoRaWAN-ISAC-868MHz/docs/ISAC_868_PCB_Top_Sheet.pdf

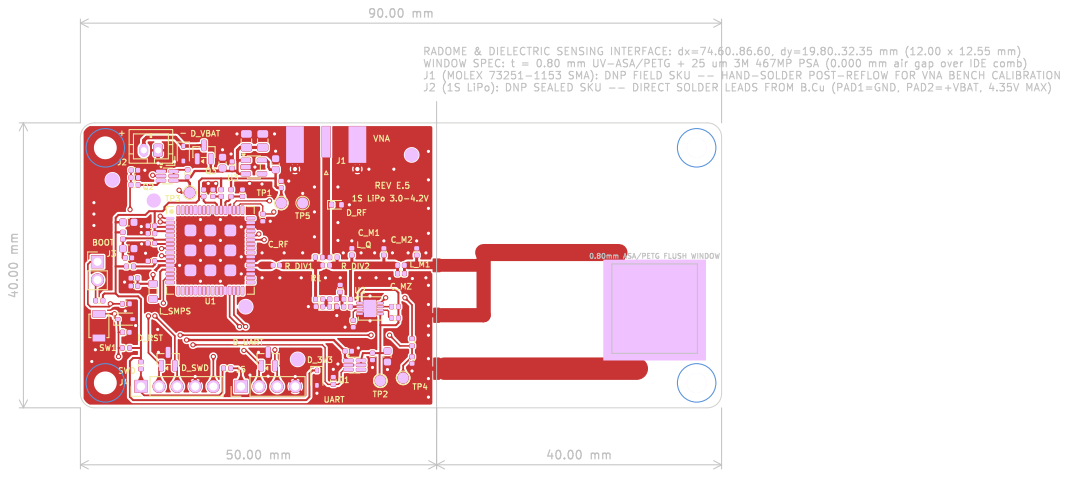
[picture p30: page 1]
