abbottsteve/LoRaWAN-ISAC-868MHz/ISAC_868_KiCad9.kicad_pcb

## KiCad design ISAC_868_KiCad9.kicad_pcb (2026-11-07)

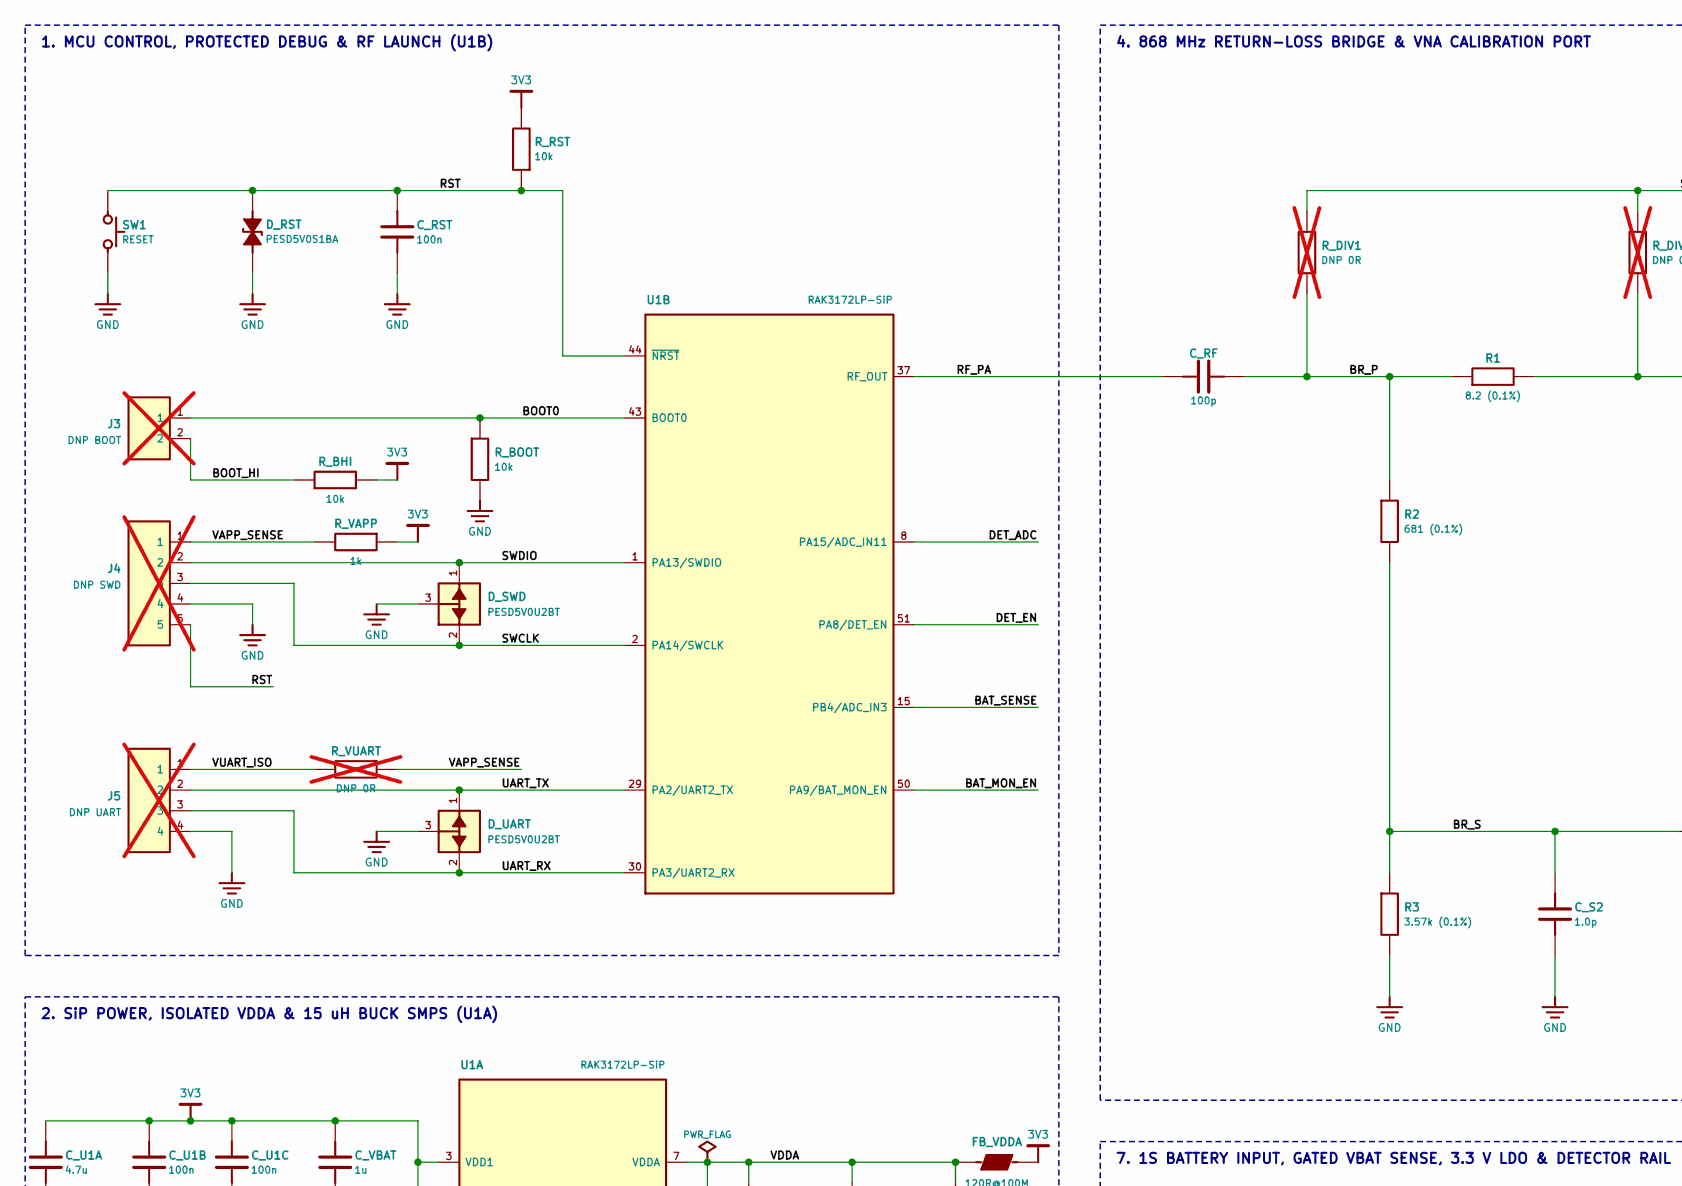
[picture p31: schematic ISAC_868_KiCad9.kicad_sch, Dual-Function 868 MHz PCB Antenna-Sensor (ISAC), part in row 1, column 1]

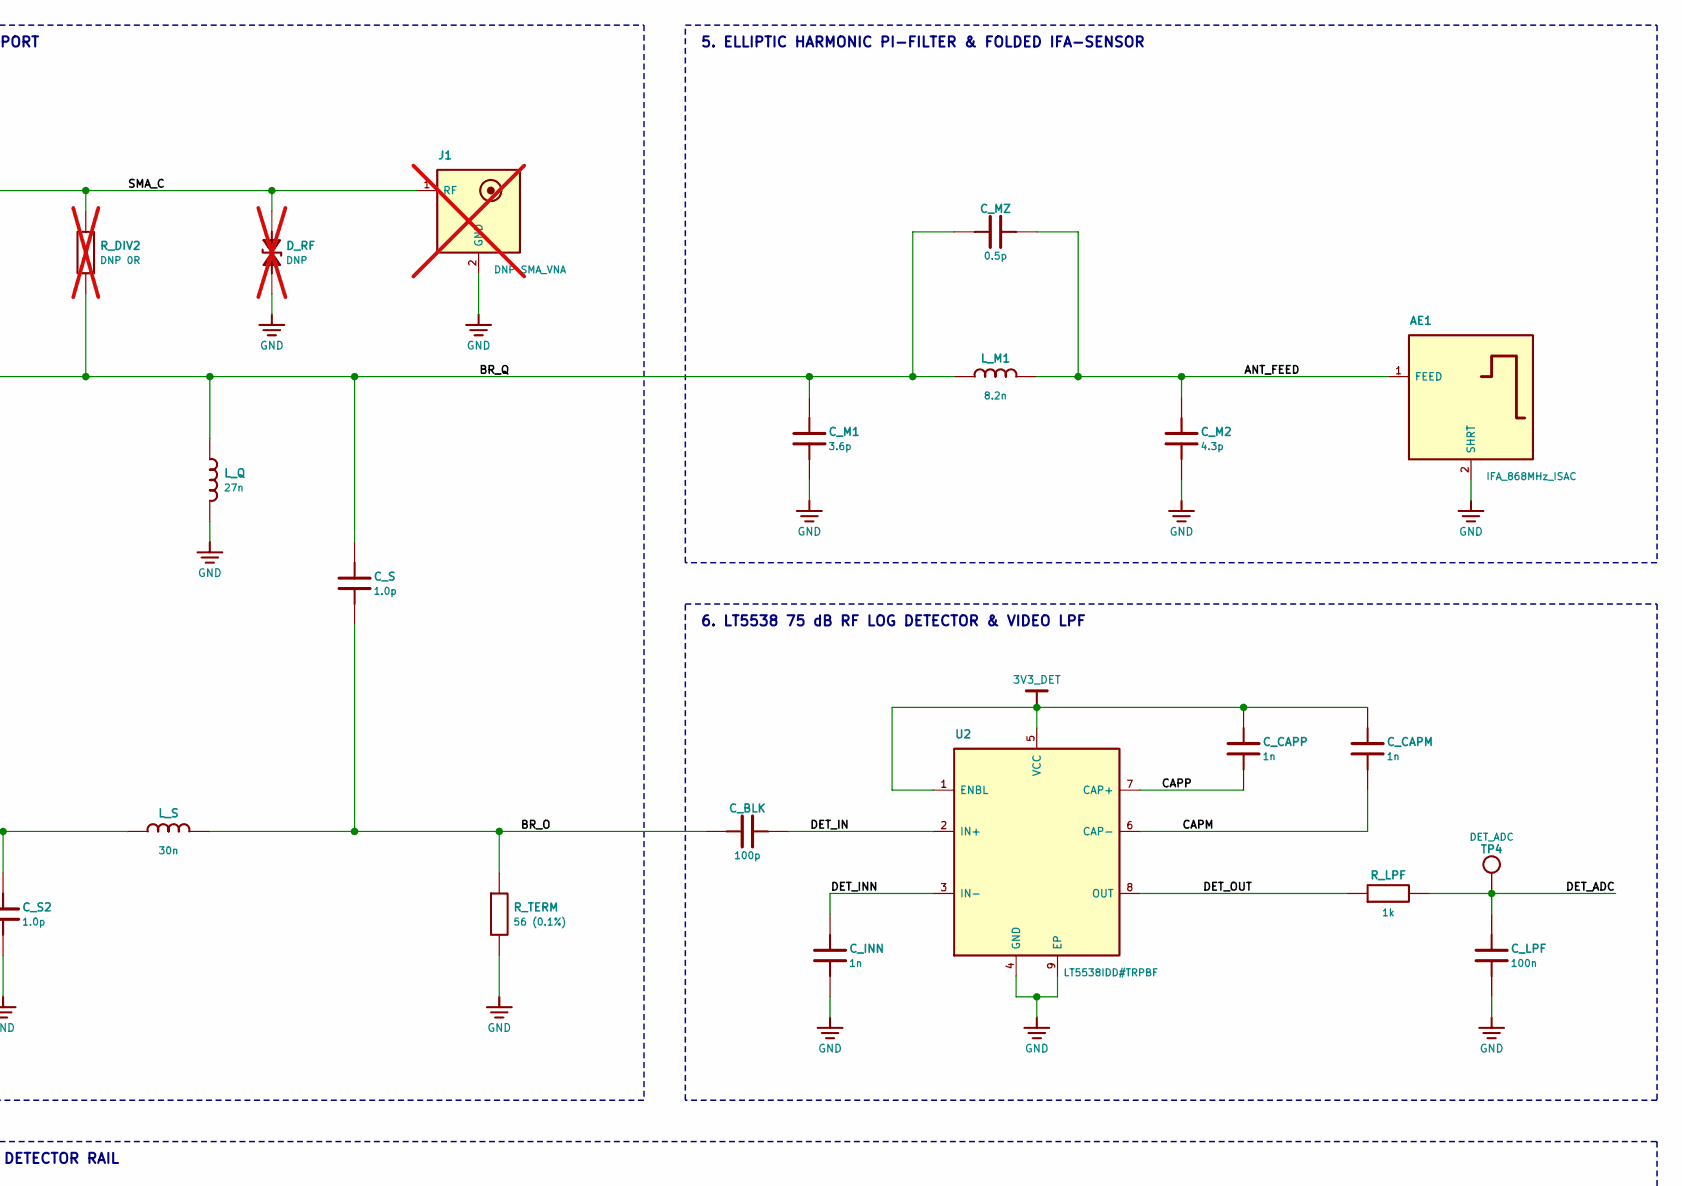
[picture p32: schematic ISAC_868_KiCad9.kicad_sch, Dual-Function 868 MHz PCB Antenna-Sensor (ISAC), part in row 1, column 2]

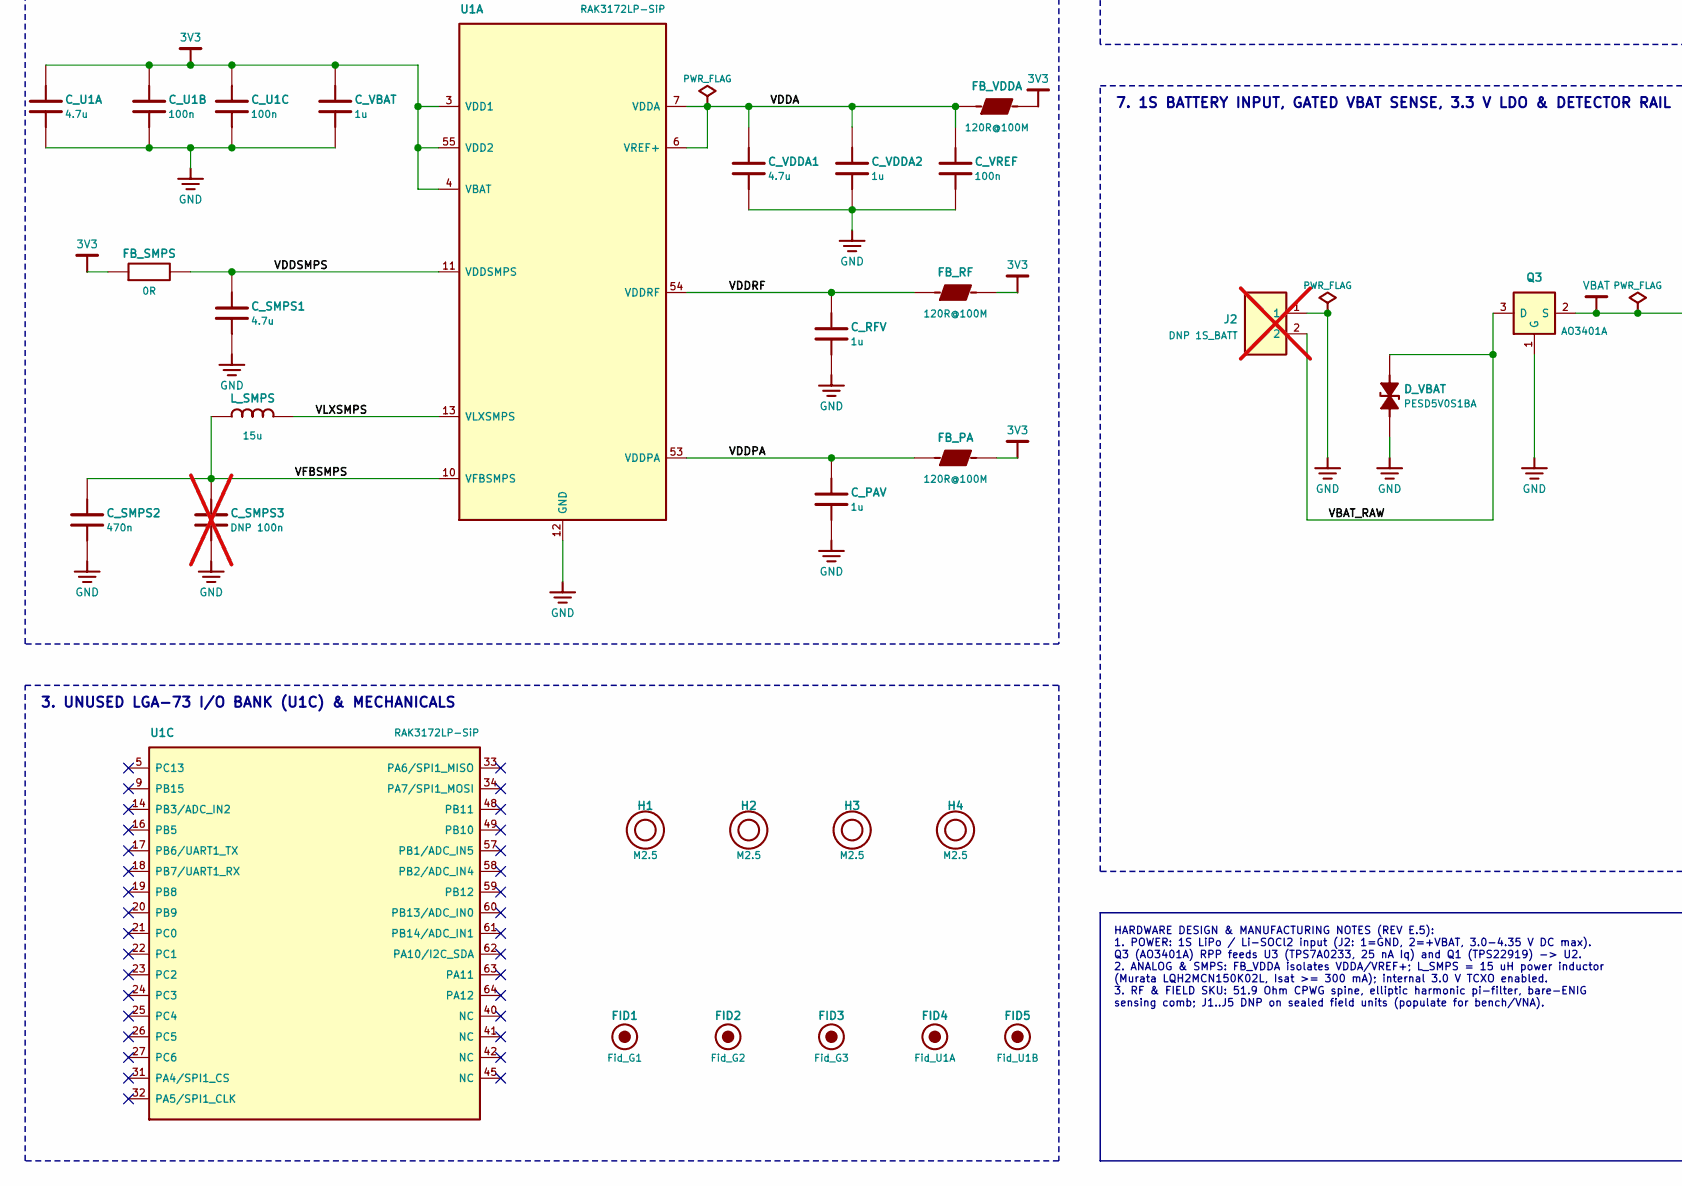
[picture p33: schematic ISAC_868_KiCad9.kicad_sch, Dual-Function 868 MHz PCB Antenna-Sensor (ISAC), part in row 2, column 1]

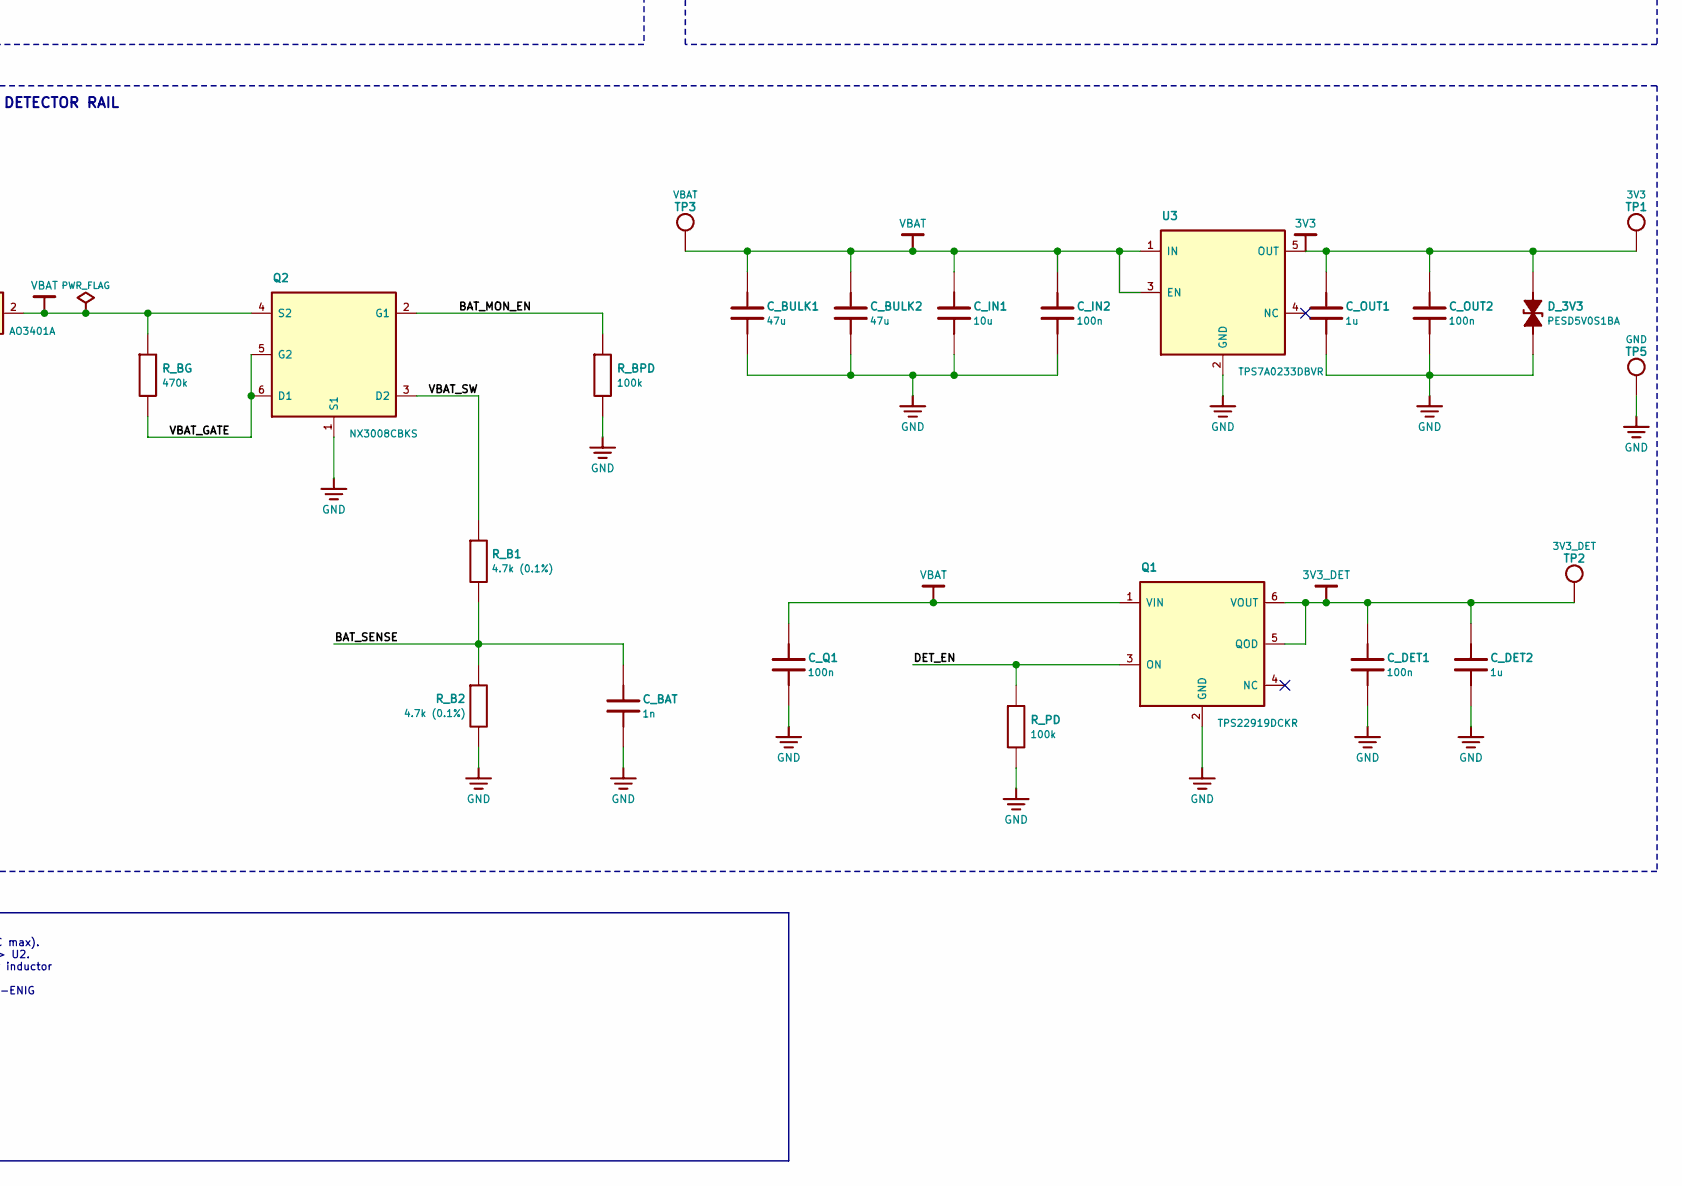
[picture p34: schematic ISAC_868_KiCad9.kicad_sch, Dual-Function 868 MHz PCB Antenna-Sensor (ISAC), part in row 2, column 2]

Parts:
AE1: IFA_868MHz_ISAC; IFA_868MHz_ISAC_40x20mm; MPN PCB trace
C_BAT: 1n; C_0402_1005Metric; MPN GRM1555C1H102JA01D; LCSC C76947
C_BLK: 100p; C_0402_1005Metric; MPN GJM1555C1H101JB01D; LCSC Authorized: DigiKey/Mouser
C_BULK1, C_BULK2: 47u; C_0805_2012Metric; MPN GRM21BR61A476ME15L; LCSC C124129
C_CAPM: 1n; C_0402_1005Metric; MPN GRM1555C1H102JA01D; LCSC C76947
C_CAPP: 1n; C_0402_1005Metric; MPN GRM1555C1H102JA01D; LCSC C76947
C_DET1: 100n; C_0402_1005Metric; MPN GRM155R71C104KA88D; LCSC C71629
C_DET2: 1u; C_0603_1608Metric; MPN GRM188R71E105KA12D; LCSC C86020
C_IN1: 10u; C_0603_1608Metric; MPN GRM188R61E106MA73D; LCSC C91606
C_IN2: 100n; C_0402_1005Metric; MPN GRM155R71C104KA88D; LCSC C71629
C_INN: 1n; C_0402_1005Metric; MPN GRM1555C1H102JA01D; LCSC C76947
C_LPF: 100n; C_0402_1005Metric; MPN GRM155R71C104KA88D; LCSC C71629
C_M1: 3.6p; C_0402_1005Metric; MPN GJM1555C1H3R6WB01D; LCSC Authorized: DigiKey/Mouser
C_M2: 4.3p; C_0402_1005Metric; MPN GJM1555C1H4R3WB01D; LCSC Authorized: DigiKey/Mouser
C_MZ: 0.5p; C_0402_1005Metric; MPN GJM1555C1HR50WB01D; LCSC Authorized: DigiKey/Mouser
C_OUT1: 1u; C_0603_1608Metric; MPN GRM188R71E105KA12D; LCSC C86020
C_OUT2: 100n; C_0402_1005Metric; MPN GRM155R71C104KA88D; LCSC C71629
C_PAV: 1u; C_0402_1005Metric; MPN GRM155R61E105KA12D; LCSC C77009
C_Q1: 100n; C_0402_1005Metric; MPN GRM155R71C104KA88D; LCSC C71629
C_RF: 100p; C_0402_1005Metric; MPN GJM1555C1H101JB01D; LCSC Authorized: DigiKey/Mouser
C_RFV: 1u; C_0402_1005Metric; MPN GRM155R61E105KA12D; LCSC C77009
C_RST: 100n; C_0402_1005Metric; MPN GRM155R71C104KA88D; LCSC C71629
C_S, C_S2: 1.0p; C_0402_1005Metric; MPN GJM1555C1H1R0WB01D; LCSC C161339
C_SMPS1: 4.7u; C_0402_1005Metric; MPN GRM155R61A475MEAAD; LCSC C335105
C_SMPS2: 470n; C_0402_1005Metric; MPN GRM155R71C474KA01D; LCSC C52923
C_SMPS3: DNP 100n; C_0402_1005Metric_DNP_NoPaste; MPN GRM155R71C104KA88D; LCSC C71629; not fitted
C_U1A: 4.7u; C_0603_1608Metric; MPN GRM188R61E475KE11D; LCSC C90057
C_U1B, C_U1C: 100n; C_0402_1005Metric; MPN GRM155R71C104KA88D; LCSC C71629
C_VBAT: 1u; C_0402_1005Metric; MPN GRM155R61E105KA12D; LCSC C77009
C_VDDA1: 4.7u; C_0603_1608Metric; MPN GRM188R61E475KE11D; LCSC C90057
C_VDDA2: 1u; C_0402_1005Metric; MPN GRM155R61E105KA12D; LCSC C77009
C_VREF: 100n; C_0402_1005Metric; MPN GRM155R71C104KA88D; LCSC C71629
D_3V3: PESD5V0S1BA; D_SOD-323; MPN PESD5V0S1BA,115; LCSC C19224
D_RF: DNP; D_SOD-523_DNP_NoPaste; MPN ESD9B5.0ST5G; LCSC Authorized: DigiKey/Mouser; not fitted
D_RST: PESD5V0S1BA; D_SOD-323; MPN PESD5V0S1BA,115; LCSC C19224
D_SWD: PESD5V0U2BT; SOT-23; MPN PESD5V0U2BT,215; LCSC Authorized: DigiKey/Mouser
D_UART: PESD5V0U2BT; SOT-23; MPN PESD5V0U2BT,215; LCSC Authorized: DigiKey/Mouser
D_VBAT: PESD5V0S1BA; D_SOD-323; MPN PESD5V0S1BA,115; LCSC C19224
FB_PA: 120R@100M; L_0402_1005Metric; MPN BLM15AG121SN1D; LCSC C85812
FB_RF: 120R@100M; L_0402_1005Metric; MPN BLM15AG121SN1D; LCSC C85812
FB_SMPS: 0R; R_0402_1005Metric; MPN RC0402JR-070RL; LCSC C60485
FB_VDDA: 120R@100M; L_0402_1005Metric; MPN BLM15AG121SN1D; LCSC C85812
FID1: Fid_G1; Fiducial_1mm_Mask2mm
FID2: Fid_G2; Fiducial_1mm_Mask2mm
FID3: Fid_G3; Fiducial_1mm_Mask2mm
FID4: Fid_U1A; Fiducial_1mm_Mask2mm
FID5: Fid_U1B; Fiducial_1mm_Mask2mm
H1, H2, H3, H4: M2.5; MountingHole_2.7mm_M2.5
J1: DNP SMA_VNA; SMA_Molex_73251-1153_EdgeMount_Horizontal_HandSolder; MPN 73251-1153; LCSC Authorized: Mouser/DigiKey; not fitted
J2: DNP 1S_BATT; JST_PH_B2B-PH-K_1x02_P2.00mm_Vertical; MPN B2B-PH-K-S; LCSC C131337; not fitted
J3: DNP BOOT; PinHeader_1x02_P2.54mm_Vertical; MPN PZ254V-11-02P; LCSC C492401; not fitted
J4: DNP SWD; PinHeader_1x05_P2.54mm_Vertical; MPN PZ254V-11-05P; LCSC C492404; not fitted
J5: DNP UART; PinHeader_1x04_P2.54mm_Vertical; MPN PZ254V-11-04P; LCSC C492403; not fitted
L_M1: 8.2n; L_0402_1005Metric; MPN LQW15AN8N2G00D; LCSC Authorized: DigiKey/Mouser
L_Q: 27n; L_0402_1005Metric; MPN LQW15AN27NG00D; LCSC Authorized: DigiKey/Mouser
L_S: 30n; L_0402_1005Metric; MPN LQW15AN30NG00D; LCSC Authorized: DigiKey/Mouser
L_SMPS: 15u; L_0805_2012Metric; MPN LQH2MCN150K02L; LCSC C86089
Q1: TPS22919DCKR; SOT-363_SC-70-6; MPN TPS22919DCKR; LCSC Authorized: DigiKey/Mouser
Q2: NX3008CBKS; SOT-363_SC-70-6; MPN NX3008CBKS,115; LCSC C456076
Q3: AO3401A; SOT-23; MPN AO3401A; LCSC C15127
R1: 8.2 (0.1%); R_0402_1005Metric; MPN RT0402BRD078R2L; LCSC Authorized: DigiKey/Mouser
R2: 681 (0.1%); R_0402_1005Metric; MPN RG1005P-6810-B-T5; LCSC Authorized: DigiKey/Mouser
R3: 3.57k (0.1%); R_0402_1005Metric; MPN RG1005P-3571-B-T5; LCSC Authorized: DigiKey/Mouser
R_B1, R_B2: 4.7k (0.1%); R_0402_1005Metric; MPN RG1005P-472-B-T5; LCSC Authorized: DigiKey/Mouser
R_BG: 470k; R_0402_1005Metric; MPN RC0402FR-07470KL; LCSC C482181
R_BHI: 10k; R_0402_1005Metric; MPN RC0402FR-0710KL; LCSC C60490
R_BOOT: 10k; R_0402_1005Metric; MPN RC0402FR-0710KL; LCSC C60490
R_BPD: 100k; R_0402_1005Metric; MPN RC0402FR-07100KL; LCSC C60491
R_DIV1, R_DIV2: DNP 0R; R_0402_1005Metric_DNP_NoPaste; MPN RC0402JR-070RL; LCSC C60485; not fitted
R_LPF: 1k; R_0402_1005Metric; MPN RC0402FR-071KL; LCSC C106235
R_PD: 100k; R_0402_1005Metric; MPN RC0402FR-07100KL; LCSC C60491
R_RST: 10k; R_0402_1005Metric; MPN RC0402FR-0710KL; LCSC C60490
R_TERM: 56 (0.1%); R_0402_1005Metric; MPN RG1005P-560-B-T5; LCSC Authorized: DigiKey/Mouser
R_VAPP: 1k; R_0402_1005Metric; MPN RC0402FR-071KL; LCSC C106235
R_VUART: DNP 0R; R_0402_1005Metric_DNP_NoPaste; MPN RC0402JR-070RL; LCSC C60485; not fitted
SW1: RESET; SW_SPST_B3U-1000P; MPN B3U-1000P; LCSC C231329
TP1: 3V3; TestPoint_Pad_D1.5mm
TP2: 3V3_DET; TestPoint_Pad_D1.5mm
TP3: VBAT; TestPoint_Pad_D1.5mm
TP4: DET_ADC; TestPoint_Pad_D1.5mm
TP5: GND; TestPoint_Pad_D1.5mm
U1: RAK3172LP-SiP; RAK3172LP-SiP_LGA-73_12x12mm_P0.6mm; MPN RAK3172LP-SIP-8-SM-NI; LCSC Authorized: RAKwireless/Mouser/DigiKey
U2: LT5538IDD#TRPBF; LT5538IDD_DFN-8-1EP_3x3mm_P0.5mm_EP1.65x2.38mm; MPN LT5538IDD#TRPBF; LCSC Authorized: DigiKey/Mouser
U3: TPS7A0233DBVR; SOT-23-5; MPN TPS7A0233DBVR; LCSC C2873330

Connections:
3V3: C_OUT1.1, C_OUT2.1, C_U1A.1, C_U1B.1, C_U1C.1, C_VBAT.1, D_3V3.1, FB_PA.2, FB_RF.2, FB_SMPS.1, FB_VDDA.2, R_BHI.2, R_RST.2, R_VAPP.1, TP1.1, U1.3 (VDD1), U1.4 (VBAT), U1.55 (VDD2), U3.5 (OUT)
3V3_DET: C_CAPM.2, C_CAPP.2, C_DET1.1, C_DET2.1, Q1.5 (QOD), Q1.6 (VOUT), TP2.1, U2.1 (ENBL), U2.5 (VCC)
/ANT_FEED: AE1.1 (FEED), C_M2.1, C_MZ.2, L_M1.2
/BAT_MON_EN: Q2.2 (G1), R_BPD.1, U1.50 (PA9/BAT_MON_EN)
/BAT_SENSE: C_BAT.1, R_B1.2, R_B2.1, U1.15 (PB4/ADC_IN3)
/BOOT0: J3.1, R_BOOT.1, U1.43 (BOOT0)
/BOOT_HI: J3.2, R_BHI.1
/BR_O: C_BLK.1, C_S.2, L_S.2, R_TERM.1
/BR_P: C_RF.2, R1.1, R2.1, R_DIV1.1
/BR_Q: C_M1.1, C_MZ.1, C_S.1, L_M1.1, L_Q.1, R1.2, R_DIV2.1
/BR_S: C_S2.1, L_S.1, R2.2, R3.1
/CAPM: C_CAPM.1, U2.6 (CAP-)
/CAPP: C_CAPP.1, U2.7 (CAP+)
/DET_ADC: C_LPF.1, R_LPF.2, TP4.1, U1.8 (PA15/ADC_IN11)
/DET_EN: Q1.3 (ON), R_PD.1, U1.51 (PA8/DET_EN)
/DET_IN: C_BLK.2, U2.2 (IN+)
/DET_INN: C_INN.1, U2.3 (IN-)
/DET_OUT: R_LPF.1, U2.8 (OUT)
/RF_PA: C_RF.1, U1.37 (RF_OUT)
/RST: C_RST.1, D_RST.1, J4.5, R_RST.1, SW1.1, U1.44 (~NRST)
/SMA_C: D_RF.1, J1.1 (RF), R_DIV1.2, R_DIV2.2
/SWCLK: D_SWD.2 (IO2), J4.3, U1.2 (PA14/SWCLK)
/SWDIO: D_SWD.1 (IO1), J4.2, U1.1 (PA13/SWDIO)
/UART_RX: D_UART.2 (IO2), J5.3, U1.30 (PA3/UART2_RX)
/UART_TX: D_UART.1 (IO1), J5.2, U1.29 (PA2/UART2_TX)
/VAPP_SENSE: J4.1, R_VAPP.2, R_VUART.1
/VBAT_GATE: Q2.5 (G2), Q2.6 (D1), R_BG.2
/VBAT_RAW: D_VBAT.1, J2.2, Q3.3 (D)
/VBAT_SW: Q2.3 (D2), R_B1.1
/VDDA: C_VDDA1.1, C_VDDA2.1, C_VREF.1, FB_VDDA.1, U1.6 (VREF+), U1.7 (VDDA)
/VDDPA: C_PAV.1, FB_PA.1, U1.53 (VDDPA)
/VDDRF: C_RFV.1, FB_RF.1, U1.54 (VDDRF)
/VDDSMPS: C_SMPS1.1, FB_SMPS.2, U1.11 (VDDSMPS)
/VFBSMPS: C_SMPS2.1, C_SMPS3.1, L_SMPS.1, U1.10 (VFBSMPS)
/VLXSMPS: L_SMPS.2, U1.13 (VLXSMPS)
/VUART_ISO: J5.1, R_VUART.2
GND: AE1.2 (SHRT), C_BAT.2, C_BULK1.2, C_BULK2.2, C_DET1.2, C_DET2.2, C_IN1.2, C_IN2.2, C_INN.2, C_LPF.2, C_M1.2, C_M2.2, C_OUT1.2, C_OUT2.2, C_PAV.2, C_Q1.2, C_RFV.2, C_RST.2, C_S2.2, C_SMPS1.2, C_SMPS2.2, C_SMPS3.2, C_U1A.2, C_U1B.2, C_U1C.2, C_VBAT.2, C_VDDA1.2, C_VDDA2.2, C_VREF.2, D_3V3.2, D_RF.2, D_RST.2, D_SWD.3 (GND), D_UART.3 (GND), D_VBAT.2, J1.2 (GND), J2.1, J4.4, J5.4, L_Q.2, Q1.2 (GND), Q2.1 (S1), Q3.1 (G), R3.2, R_B2.2, R_BOOT.2, R_BPD.2, R_PD.2, R_TERM.2, SW1.2, TP5.1, U1.12 (GND), U1.28 (GND), U1.35 (GND), U1.36 (GND), U1.38 (GND), U1.39 (GND), U1.46 (GND), U1.47 (GND), U1.52 (GND), U1.56 (GND), U1.65 (GND), U1.66 (GND), U1.67 (GND), U1.68 (GND), U1.69 (GND), U1.70 (GND), U1.71 (GND), U1.72 (GND), U1.73 (GND), U2.4 (GND), U2.9 (EP), U3.2 (GND)
VBAT: C_BULK1.1, C_BULK2.1, C_IN1.1, C_IN2.1, C_Q1.1, Q1.1 (VIN), Q2.4 (S2), Q3.2 (S), R_BG.1, TP3.1, U3.1 (IN), U3.3 (EN)

Notes on the sheet:
1. MCU CONTROL, PROTECTED DEBUG & RF LAUNCH (U1B)
2. SiP POWER, ISOLATED VDDA & 15 uH BUCK SMPS (U1A)
3. UNUSED LGA-73 I/O BANK (U1C) & MECHANICALS
4. 868 MHz RETURN-LOSS BRIDGE & VNA CALIBRATION PORT
5. ELLIPTIC HARMONIC PI-FILTER & FOLDED IFA-SENSOR
6. LT5538 75 dB RF LOG DETECTOR & VIDEO LPF
7. 1S BATTERY INPUT, GATED VBAT SENSE, 3.3 V LDO & DETECTOR RAIL
HARDWARE DESIGN & MANUFACTURING NOTES (REV E.5): 1. POWER: 1S LiPo / Li-SOCl2 input (J2: 1=GND, 2=+VBAT, 3.0-4.35 V DC max). Q3 (AO3401A) RPP feeds U3 (TPS7A0233, 25 nA Iq) and Q1 (TPS22919) -> U2. 2. ANALOG & SMPS: FB_VDDA isolates VDDA/VREF+; L_SMPS = 15 uH power inductor (Murata LQH2MCN150K02L, 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

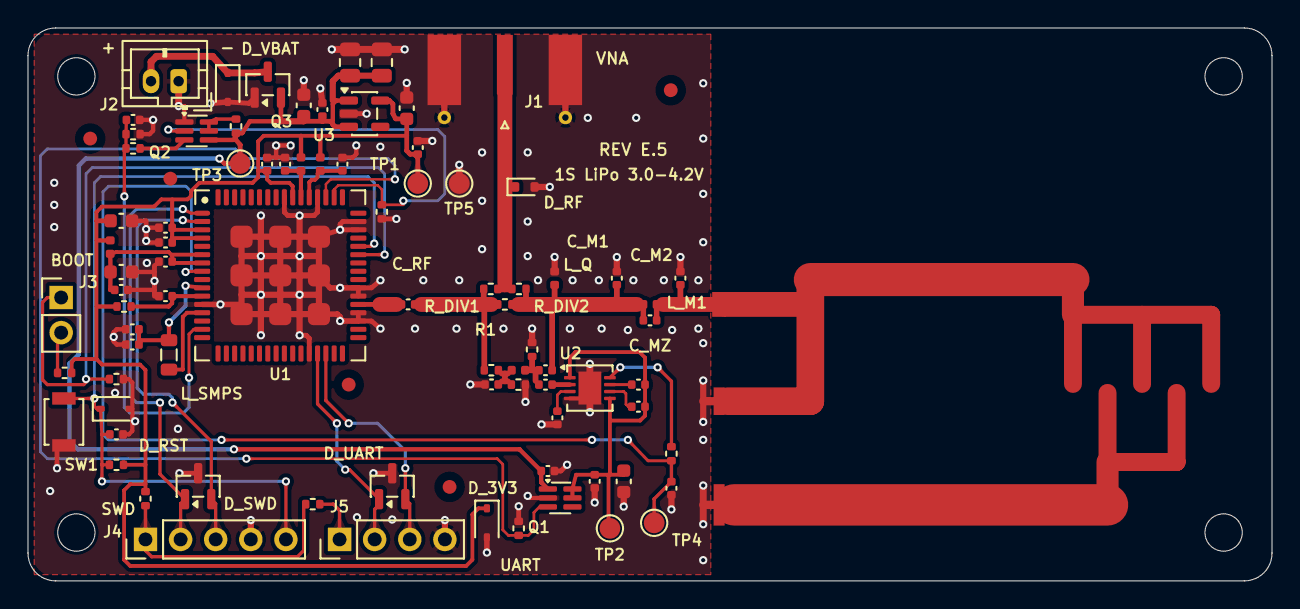
[picture p35: board ISAC_868_KiCad9.kicad_pcb from above]

Board: 2 copper layers, 90.0 x 40.0 mm, 92 parts (0 on the bottom side), 38 nets.
