abbottsteve/LoRaWAN-ISAC-868MHz/tools/gen_sch.py

#!/usr/bin/env python3
"""
Generate the human-crafted KiCad 9 schematic + local symbol library for the
868 MHz Dual-Function ISAC Antenna-Sensor Node (Rev E.5).

Design highlights (Rev E.5 PCBWay Turnkey Hardware):
  * Clean multi-unit functional decomposition of U1 (`RAK3172LP-SiP`, LGA-73):
    - `U1A`: Digital/Analog/RF Power Conditioning (`VDD1/2`, isolated `VDDA/VREF+`,
      `VDDRF`, `VDDPA`), 15 uH internal buck SMPS (`LQH2MCN150K02L`), and LGA GND bank.
    - `U1B`: STM32WLE5JC Control, Protected SWD/UART2/BOOT Debug, ADC Sensing &
      Sub-GHz `RF_OUT` (`Pin 37`, RFO_LP) launching left-to-right onto the RF spine.
    - `U1C`: Compact auxiliary termination bank for the 33 unused LGA-73 I/O & NC pins.
  * Strict 2.54 mm (100 mil) grid alignment across all symbols, pins, wires,
    junctions, and power symbols (0 ERC errors, 0 ERC warnings) + automated 2D
    Shapely bounding-box collision & A3 border containment verification.
  * Ultra-low-sleep (< 2.5 uA typ across VBAT = 3.0..4.2 V):
    - U3 TI TPS7A0233DBVR (SOT-23-5: 1=IN, 2=GND, 3=EN, 4=NC, 5=OUT;
      Iq = 25 nA typ, 200 mA continuous) + Q3 AO3401A ideal diode.
    - Independent PA9 (BAT_MON_EN) high-side gated battery divider via Q2
      (Nexperia NX3008CBKS,115 complementary +/-30 V N+P MOSFET, SOT-363) +
      R_BG (470k) + R_B1/R_B2 (4.7k 0.1%) + C_BAT (1n 50V C0G): 0 nA sleep bleed.
    - Header LiPo back-feed isolation: R_VAPP (1k) on J4.1 VAPP_SENSE,
      R_VUART (DNP 0R) on J5.1 VUART_ISO, R_BHI (10k) on J3.2 BOOT_HI, D_3V3 TVS.
  * Co-optimized Elliptic Low-Pass Harmonic Pi-Network (C_M1=3.6p, L_M1=8.2n ||
    C_MZ=0.5p, C_M2=4.3p) + Parasitic-Controlled Bridge (R1=8.2R Yageo RT0402BRD078R2L,
    zero RF test points, DC TP1..TP5 only).

Run:  python3 tools/gen_sch.py
"""
from collections import defaultdict
import csv
import os
import re
import subprocess
import tempfile
import uuid

PROJECT = "ISAC_868_KiCad9"
HERE = os.path.dirname(os.path.abspath(__file__))
ROOT = os.path.dirname(HERE)
NS = uuid.UUID("0d6f5c2e-4a1b-4c7e-9f10-2b3c4d5e6f70")

G = 2.54  # 100 mil schematic grid in mm


def u(tag):
    return str(uuid.uuid5(NS, f"{PROJECT}:{tag}"))


def gm(n):
    """Convert integer grid units (2.54 mm) to rounded mm."""
    return round(n * G, 4)


# --------------------------------------------------------------------------
# S-expression formatter
# --------------------------------------------------------------------------
def sx_flat(obj):
    if isinstance(obj, list):
        return "(" + " ".join(sx_flat(x) for x in obj) + ")"
    return str(obj)


def sx(obj, ind=0):
    sp = "  " * ind
    if isinstance(obj, list):
        if not obj:
            return "()"
        flat = sx_flat(obj)
        if len(flat) <= 92 and "\n" not in flat:
            return flat
        head, rest = obj[0], obj[1:]
        if not rest:
            return "(" + sx(head, 0) + ")"
        body = "\n".join(sp + "  " + sx(x, ind + 1) for x in rest)
        return "(" + sx(head, 0) + "\n" + body + "\n" + sp + ")"
    return str(obj)


def q(s):
    return '"' + s.replace("\\", "\\\\").replace('"', '\\"').replace("\n", "\\n") + '"'


# --------------------------------------------------------------------------
# Symbol library definitions (all pin endpoints on exact multiples of 2.54 mm)
# --------------------------------------------------------------------------
SYMS = {}


def rect(x1, y1, x2, y2, fill="none", width=0.254):
    return ["rectangle", ["start", round(x1, 4), round(y1, 4)],
            ["end", round(x2, 4), round(y2, 4)],
            ["stroke", ["width", width], ["type", "default"]],
            ["fill", ["type", fill]]]


def poly(pts, width=0.254, fill="none"):
    return ["polyline", ["pts"] + [["xy", round(x, 4), round(y, 4)] for x, y in pts],
            ["stroke", ["width", width], ["type", "default"]],
            ["fill", ["type", fill]]]


def circ(x, y, r, width=0.254, fill="none"):
    return ["circle", ["center", round(x, 4), round(y, 4)], ["radius", round(r, 4)],
            ["stroke", ["width", width], ["type", "default"]],
            ["fill", ["type", fill]]]


def arc(p1, pm, p2, width=0.254):
    return ["arc", ["start", round(p1[0], 4), round(p1[1], 4)],
            ["mid", round(pm[0], 4), round(pm[1], 4)],
            ["end", round(p2[0], 4), round(p2[1], 4)],
            ["stroke", ["width", width], ["type", "default"]],
            ["fill", ["type", "none"]]]


def add_sym(name, hw_g, hh_g, pins, graphics, ref_prefix,
            hide_pin_nums=False, hide_pin_names=False, is_power=False,
            in_bom="yes", on_board="yes", units=None):
    SYMS[name] = dict(
        hw=gm(hw_g), hh=gm(hh_g), pins=pins, graphics=graphics,
        ref=ref_prefix, hide_nums=hide_pin_nums, hide_names=hide_pin_names,
        is_power=is_power, in_bom=in_bom, on_board=on_board, units=units,
    )


def box_pin(side, hw_g, hh_g, num, name, etype, pos_g, hide=False, unit=1):
    if side == "L":
        return dict(num=num, name=name, etype=etype, unit=unit,
                    lx=gm(-hw_g - 1), ly=gm(pos_g), rot=0, length=G, hide=hide)
    if side == "R":
        return dict(num=num, name=name, etype=etype, unit=unit,
                    lx=gm(hw_g + 1), ly=gm(pos_g), rot=180, length=G, hide=hide)
    if side == "T":
        return dict(num=num, name=name, etype=etype, unit=unit,
                    lx=gm(pos_g), ly=gm(hh_g + 1), rot=270, length=G, hide=hide)
    if side == "B":
        return dict(num=num, name=name, etype=etype, unit=unit,
                    lx=gm(pos_g), ly=gm(-hh_g - 1), rot=90, length=G, hide=hide)
    raise ValueError(side)


# ---- U1: RAK3172LP-SiP (3-Unit Functional Symbol: U1A, U1B, U1C) -----------
# Unit 1 (U1A): Power Supplies, Ferrite-Isolated Analog/RF/PA & 15 uH SMPS (29 pins)
u1a_hw, u1a_hh = 5, 12
u1a_pins = [
    box_pin("L", u1a_hw, u1a_hh, 3, "VDD1", "power_in", 8, unit=1),
    box_pin("L", u1a_hw, u1a_hh, 55, "VDD2", "power_in", 6, unit=1),
    box_pin("L", u1a_hw, u1a_hh, 4, "VBAT", "power_in", 4, unit=1),
    box_pin("L", u1a_hw, u1a_hh, 11, "VDDSMPS", "passive", 0, unit=1),
    box_pin("L", u1a_hw, u1a_hh, 13, "VLXSMPS", "passive", -7, unit=1),
    box_pin("L", u1a_hw, u1a_hh, 10, "VFBSMPS", "passive", -10, unit=1),

    box_pin("R", u1a_hw, u1a_hh, 7, "VDDA", "power_in", 8, unit=1),
    box_pin("R", u1a_hw, u1a_hh, 6, "VREF+", "power_in", 6, unit=1),
    box_pin("R", u1a_hw, u1a_hh, 54, "VDDRF", "passive", -1, unit=1),
    box_pin("R", u1a_hw, u1a_hh, 53, "VDDPA", "passive", -9, unit=1),

    box_pin("B", u1a_hw, u1a_hh, 12, "GND", "power_in", 0, hide=False, unit=1),
] + [
    box_pin("B", u1a_hw, u1a_hh, gpin, "GND", "passive", 0, hide=True, unit=1)
    for gpin in (28, 35, 36, 38, 39, 46, 47, 52, 56, 65, 66, 67, 68, 69, 70, 71, 72, 73)
]

# Unit 2 (U1B): STM32WLE5JC Control, Protected Debug, ADC & Sub-GHz Radio (11 pins)
u1b_hw, u1b_hh = 6, 14
u1b_pins = [
    box_pin("L", u1b_hw, u1b_hh, 44, "~{NRST}", "input", 12, unit=2),
    box_pin("L", u1b_hw, u1b_hh, 43, "BOOT0", "input", 9, unit=2),
    box_pin("L", u1b_hw, u1b_hh, 1, "PA13/SWDIO", "bidirectional", 2, unit=2),
    box_pin("L", u1b_hw, u1b_hh, 2, "PA14/SWCLK", "bidirectional", -2, unit=2),
    box_pin("L", u1b_hw, u1b_hh, 29, "PA2/UART2_TX", "output", -9, unit=2),
    box_pin("L", u1b_hw, u1b_hh, 30, "PA3/UART2_RX", "input", -13, unit=2),

    box_pin("R", u1b_hw, u1b_hh, 37, "RF_OUT", "bidirectional", 11, unit=2),
    box_pin("R", u1b_hw, u1b_hh, 8, "PA15/ADC_IN11", "input", 3, unit=2),
    box_pin("R", u1b_hw, u1b_hh, 51, "PA8/DET_EN", "output", -1, unit=2),
    box_pin("R", u1b_hw, u1b_hh, 15, "PB4/ADC_IN3", "input", -5, unit=2),
    box_pin("R", u1b_hw, u1b_hh, 50, "PA9/BAT_MON_EN", "output", -9, unit=2),
]

# Unit 3 (U1C): Unused LGA-73 GPIO & Internal NC Termination Bank (33 pins)
u1c_hw, u1c_hh = 8, 9
_u1c_left = [
    (5, "PC13", "bidirectional"),
    (9, "PB15", "bidirectional"),
    (14, "PB3/ADC_IN2", "bidirectional"),
    (16, "PB5", "bidirectional"),
    (17, "PB6/UART1_TX", "bidirectional"),
    (18, "PB7/UART1_RX", "bidirectional"),
    (19, "PB8", "bidirectional"),
    (20, "PB9", "bidirectional"),
    (21, "PC0", "bidirectional"),
    (22, "PC1", "bidirectional"),
    (23, "PC2", "bidirectional"),
    (24, "PC3", "bidirectional"),
    (25, "PC4", "bidirectional"),
    (26, "PC5", "bidirectional"),
    (27, "PC6", "bidirectional"),
    (31, "PA4/SPI1_CS", "bidirectional"),
    (32, "PA5/SPI1_CLK", "bidirectional"),
]
_u1c_right = [
    (33, "PA6/SPI1_MISO", "bidirectional"),
    (34, "PA7/SPI1_MOSI", "bidirectional"),
    (48, "PB11", "bidirectional"),
    (49, "PB10", "bidirectional"),
    (57, "PB1/ADC_IN5", "bidirectional"),
    (58, "PB2/ADC_IN4", "bidirectional"),
    (59, "PB12", "bidirectional"),
    (60, "PB13/ADC_IN0", "bidirectional"),
    (61, "PB14/ADC_IN1", "bidirectional"),
    (62, "PA10/I2C_SDA", "bidirectional"),
    (63, "PA11", "bidirectional"),
    (64, "PA12", "bidirectional"),
    (40, "NC", "passive"),
    (41, "NC", "passive"),
    (42, "NC", "passive"),
    (45, "NC", "passive"),
]
u1c_pins = [
    box_pin("L", u1c_hw, u1c_hh, pnum, pname, petype, 8 - idx, unit=3)
    for idx, (pnum, pname, petype) in enumerate(_u1c_left)
] + [
    box_pin("R", u1c_hw, u1c_hh, pnum, pname, petype, 8 - idx, unit=3)
    for idx, (pnum, pname, petype) in enumerate(_u1c_right)
]

rak_pins = u1a_pins + u1b_pins + u1c_pins
assert len(rak_pins) == 73 and {p["num"] for p in rak_pins} == set(range(1, 74))

rak_units = {
    1: dict(hw=gm(u1a_hw), hh=gm(u1a_hh),
            graphics=[rect(gm(-u1a_hw), gm(-u1a_hh), gm(u1a_hw), gm(u1a_hh), "background")],
            pins=u1a_pins),
    2: dict(hw=gm(u1b_hw), hh=gm(u1b_hh),
            graphics=[rect(gm(-u1b_hw), gm(-u1b_hh), gm(u1b_hw), gm(u1b_hh), "background")],
            pins=u1b_pins),
    3: dict(hw=gm(u1c_hw), hh=gm(u1c_hh),
            graphics=[rect(gm(-u1c_hw), gm(-u1c_hh), gm(u1c_hw), gm(u1c_hh), "background")],
            pins=u1c_pins),
}
add_sym("RAK3172LP-SiP", u1a_hw, u1a_hh, rak_pins,
        [rect(gm(-u1a_hw), gm(-u1a_hh), gm(u1a_hw), gm(u1a_hh), "background")],
        "U", units=rak_units)

# ---- U2: LT5538IDD (40 MHz - 3.8 GHz 75 dB Log Detector, DFN-8-1EP) ------
lt_pins = [
    box_pin("T", 4, 5, 5, "VCC", "power_in", 0),
    box_pin("L", 4, 5, 1, "ENBL", "input", 3),
    box_pin("L", 4, 5, 2, "IN+", "passive", 1),
    box_pin("L", 4, 5, 3, "IN-", "passive", -2),
    box_pin("R", 4, 5, 7, "CAP+", "passive", 3),
    box_pin("R", 4, 5, 6, "CAP-", "passive", 1),
    box_pin("R", 4, 5, 8, "OUT", "output", -2),
    box_pin("B", 4, 5, 4, "GND", "power_in", -1),
    box_pin("B", 4, 5, 9, "EP", "power_in", 1),
]
add_sym("LT5538IDD", 4, 5, lt_pins,
        [rect(gm(-4), gm(-5), gm(4), gm(5), "background")], "U")

# ---- U3: TPS7A0233DBVR (200 mA, 25 nA Nanopower-Iq 3.3 V LDO, SOT-23-5) ---
ldo_pins = [
    box_pin("L", 3, 3, 1, "IN", "power_in", 2),
    box_pin("L", 3, 3, 3, "EN", "input", 0),
    box_pin("B", 3, 3, 2, "GND", "power_in", 0),
    box_pin("R", 3, 3, 5, "OUT", "power_out", 2),
    box_pin("R", 3, 3, 4, "NC", "passive", -1),
]
add_sym("TPS7A0233DBVR", 3, 3, ldo_pins,
        [rect(gm(-3), gm(-3), gm(3), gm(3), "background")], "U")

# ---- Q1: TPS22919DCKR (Zero-Iq Load Switch, SOT-363 / SC-70-6) -----------
tps_pins = [
    box_pin("L", 3, 3, 1, "VIN", "power_in", 2),
    box_pin("L", 3, 3, 3, "ON", "input", -1),
    box_pin("B", 3, 3, 2, "GND", "power_in", 0),
    box_pin("R", 3, 3, 6, "VOUT", "power_out", 2),
    box_pin("R", 3, 3, 5, "QOD", "passive", 0),
    box_pin("R", 3, 3, 4, "NC", "passive", -2),
]
add_sym("TPS22919DCKR", 3, 3, tps_pins,
        [rect(gm(-3), gm(-3), gm(3), gm(3), "background")], "Q")

# ---- Q2: NX3008CBKS (Complementary +/-30V N+P Trench MOSFET, SOT-363) -----
nx_pins = [
    box_pin("L", 3, 3, 4, "S2", "passive", 2),
    box_pin("L", 3, 3, 5, "G2", "input", 0),
    box_pin("L", 3, 3, 6, "D1", "passive", -2),
    box_pin("B", 3, 3, 1, "S1", "passive", 0),
    box_pin("R", 3, 3, 2, "G1", "input", 2),
    box_pin("R", 3, 3, 3, "D2", "passive", -2),
]
add_sym("NX3008CBKS", 3, 3, nx_pins,
        [rect(gm(-3), gm(-3), gm(3), gm(3), "background")], "Q")

# ---- Passives (pins at +/- 2*G = +/- 5.08 mm -> 100% 2.54 mm grid!) ------
passive_lr = [
    dict(num=1, name="~", etype="passive", unit=1, lx=gm(-2), ly=0.0, rot=0, length=G, hide=False),
    dict(num=2, name="~", etype="passive", unit=1, lx=gm(2), ly=0.0, rot=180, length=G, hide=False),
]
add_sym("R", 1, 0, passive_lr,
        [rect(-2.54, -1.016, 2.54, 1.016, "none")],
        "R", hide_pin_nums=True, hide_pin_names=True)

add_sym("C", 1, 0, passive_lr,
        [poly([(-2.54, 0), (-0.635, 0)]),
         poly([(0.635, 0), (2.54, 0)]),
         poly([(-0.635, -1.905), (-0.635, 1.905)], width=0.381),
         poly([(0.635, -1.905), (0.635, 1.905)], width=0.381)],
        "C", hide_pin_nums=True, hide_pin_names=True)

add_sym("L", 1, 0, passive_lr,
        [arc((-2.54, 0), (-1.905, 0.889), (-1.27, 0)),
         arc((-1.27, 0), (-0.635, 0.889), (0.0, 0)),
         arc((0.0, 0), (0.635, 0.889), (1.27, 0)),
         arc((1.27, 0), (1.905, 0.889), (2.54, 0))],
        "L", hide_pin_nums=True, hide_pin_names=True)

add_sym("FB", 1, 0, passive_lr,
        [poly([(-2.54, 0), (-1.905, 0)]),
         poly([(1.905, 0), (2.54, 0)]),
         poly([(-1.905, -0.889), (-1.27, 0.889), (1.905, 0.889),
               (1.27, -0.889), (-1.905, -0.889)], fill="outline")],
        "FB", hide_pin_nums=True, hide_pin_names=True)

add_sym("D", 1, 0,
        [dict(num=2, name="A", etype="passive", unit=1, lx=gm(-2), ly=0.0, rot=0, length=G, hide=False),
         dict(num=1, name="K", etype="passive", unit=1, lx=gm(2), ly=0.0, rot=180, length=G, hide=False)],
        [poly([(-2.54, 0), (2.54, 0)]),
         poly([(-1.27, -1.27), (-1.27, 1.27), (1.27, 0), (-1.27, -1.27)], fill="outline"),
         poly([(0.762, -1.27), (1.27, -1.27), (1.27, 1.27), (1.778, 1.27)])],
        "D", hide_pin_nums=True, hide_pin_names=True)

add_sym("TVS_BIDIR", 1, 0, passive_lr,
        [poly([(-2.54, 0), (2.54, 0)]),
         poly([(-1.524, -1.016), (-1.524, 1.016), (0.0, 0), (-1.524, -1.016)], fill="outline"),
         poly([(1.524, -1.016), (1.524, 1.016), (0.0, 0), (1.524, -1.016)], fill="outline"),
         poly([(-0.381, -1.143), (0.0, -1.143), (0.0, 1.143), (0.381, 1.143)])],
        "D", hide_pin_nums=True, hide_pin_names=True)

add_sym("PMOS_RPP", 1, 1,
        [box_pin("L", 1, 1, 3, "D", "passive", 0),
         box_pin("R", 1, 1, 2, "S", "passive", 0),
         box_pin("B", 1, 1, 1, "G", "input", 0)],
        [rect(gm(-1), gm(-1), gm(1), gm(1), "background")], "Q")

add_sym("PESD5V0U2BT", 1, 1,
        [box_pin("T", 1, 1, 1, "IO1", "passive", 0),
         box_pin("B", 1, 1, 2, "IO2", "passive", 0),
         box_pin("L", 1, 1, 3, "GND", "passive", 0)],
        [rect(gm(-1), gm(-1), gm(1), gm(1), "background"),
         poly([(-2.54, 0), (0, 0)]),
         poly([(0, 2.54), (0, -2.54)]),
         poly([(-0.762, 0.635), (0.762, 0.635), (0, 1.778), (-0.762, 0.635)], fill="outline"),
         poly([(-0.762, -0.635), (0.762, -0.635), (0, -1.778), (-0.762, -0.635)], fill="outline")],
        "D", hide_pin_names=True)

add_sym("SW_PUSH", 1, 0,
        [dict(num=1, name="1", etype="passive", unit=1, lx=gm(-2), ly=0.0, rot=0, length=G, hide=False),
         dict(num=2, name="2", etype="passive", unit=1, lx=gm(2), ly=0.0, rot=180, length=G, hide=False)],
        [circ(-1.524, 0, 0.508), circ(1.524, 0, 0.508),
         poly([(-2.54, 0), (-2.032, 0)]), poly([(2.032, 0), (2.54, 0)]),
         poly([(-1.778, 1.016), (1.778, 1.016)]),
         poly([(0, 1.016), (0, 2.032)])],
        "SW", hide_pin_nums=True, hide_pin_names=True)

add_sym("Conn_01x02", 1, 1,
        [box_pin("R", 1, 1, 1, "1", "passive", 1),
         box_pin("R", 1, 1, 2, "2", "passive", 0)],
        [rect(gm(-1), gm(-1), gm(1), gm(2), "background")], "J")

add_sym("Conn_01x04", 1, 2,
        [box_pin("R", 1, 2, 1, "1", "passive", 2),
         box_pin("R", 1, 2, 2, "2", "passive", 1),
         box_pin("R", 1, 2, 3, "3", "passive", 0),
         box_pin("R", 1, 2, 4, "4", "passive", -1)],
        [rect(gm(-1), gm(-2), gm(1), gm(3), "background")], "J")

add_sym("Conn_01x05", 1, 2,
        [box_pin("R", 1, 2, 1, "1", "passive", 2),
         box_pin("R", 1, 2, 2, "2", "passive", 1),
         box_pin("R", 1, 2, 3, "3", "passive", 0),
         box_pin("R", 1, 2, 4, "4", "passive", -1),
         box_pin("R", 1, 2, 5, "5", "passive", -2)],
        [rect(gm(-1), gm(-3), gm(1), gm(3), "background")], "J")

add_sym("SMA", 2, 2,
        [box_pin("L", 2, 2, 1, "RF", "passive", 1),
         box_pin("B", 2, 2, 2, "GND", "passive", 0)],
        [rect(gm(-2), gm(-2), gm(2), gm(2), "background"),
         circ(1.5, gm(1), 1.3, width=0.254),
         circ(1.5, gm(1), 0.35, width=0.254, fill="outline")], "J")

add_sym("IFA", 3, 3,
        [box_pin("L", 3, 3, 1, "FEED", "passive", 1),
         box_pin("B", 3, 3, 2, "SHRT", "passive", 0)],
        [rect(gm(-3), gm(-3), gm(3), gm(3), "background"),
         poly([(1.27, 2.54), (2.54, 2.54), (2.54, 5.08),
               (5.588, 5.08), (5.588, -2.54), (6.604, -2.54)], width=0.35)],
        "AE", in_bom="no")

add_sym("TP", 0, 0,
        [dict(num=1, name="1", etype="passive", unit=1, lx=0.0, ly=gm(-1), rot=90, length=G, hide=False)],
        [circ(0, 1.016, 1.016, width=0.254)],
        "TP", hide_pin_nums=True, hide_pin_names=True, in_bom="no")

add_sym("MOUNT", 1, 1, [],
        [circ(0, 0, 1.27), circ(0, 0, 2.286)],
        "H", hide_pin_nums=True, hide_pin_names=True, in_bom="no")

add_sym("FID", 1, 1, [],
        [circ(0, 0, 0.635, fill="outline"), circ(0, 0, 1.524)],
        "FID", hide_pin_nums=True, hide_pin_names=True, in_bom="no")

# ---- Global Power Symbols & PWR_FLAG -------------------------------------
add_sym("GND", 0, 0,
        [dict(num=1, name="~", etype="power_in", unit=1, lx=0.0, ly=0.0, rot=270, length=0, hide=False)],
        [poly([(0, 0), (0, -1.27)]),
         poly([(-1.524, -1.27), (1.524, -1.27)]),
         poly([(-1.016, -1.905), (1.016, -1.905)]),
         poly([(-0.508, -2.54), (0.508, -2.54)])],
        "#PWR", hide_pin_nums=True, hide_pin_names=True, is_power=True)

for pnet in ("3V3", "VBAT", "3V3_DET"):
    add_sym(pnet, 0, 0,
            [dict(num=1, name="~", etype="power_in", unit=1, lx=0.0, ly=0.0, rot=90, length=0, hide=False)],
            [poly([(0, 0), (0, 2.032)]),
             poly([(-1.27, 2.032), (1.27, 2.032)], width=0.381)],
            "#PWR", hide_pin_nums=True, hide_pin_names=True, is_power=True)

add_sym("PWR_FLAG", 0, 0,
        [dict(num=1, name="~", etype="power_out", unit=1, lx=0.0, ly=0.0, rot=90, length=0, hide=False)],
        [poly([(0, 0), (0, 1.27), (-1.016, 1.905), (0, 2.54), (1.016, 1.905), (0, 1.27)])],
        "#FLG", hide_pin_nums=True, hide_pin_names=True, is_power=True)


def _format_pin_sexp(p):
    pin_el = ["pin", p["etype"], "line",
              ["at", p["lx"], p["ly"], p["rot"]],
              ["length", round(p["length"], 4)]]
    if p.get("hide"):
        pin_el.append(["hide", "yes"])
    pin_el.append(["name", q(p["name"]), ["effects", ["font", ["size", 0.92, 0.92]]]])
    pin_el.append(["number", q(str(p["num"])), ["effects", ["font", ["size", 0.88, 0.88]]]])
    return pin_el


def sym_entry(name, full=False):
    s = SYMS[name]
    hw, hh = s["hw"], s["hh"]
    out = ["symbol", q(("ISAC:" if full else "") + name)]
    if s["is_power"]:
        out.append(["power"])
    if s["hide_nums"]:
        out.append(["pin_numbers", ["hide", "yes"]])
    if s["hide_names"]:
        out.append(["pin_names", ["offset", 0], ["hide", "yes"]])
    else:
        out.append(["pin_names", ["offset", 0.635]])
    out += [["exclude_from_sim", "no"],
            ["in_bom", s["in_bom"]],
            ["on_board", s["on_board"]]]

    if s["is_power"]:
        val_y = -4.0 if name == "GND" else 3.556
        out += [
            ["property", q("Reference"), q(s["ref"]), ["at", 0, -6.35, 0],
             ["effects", ["font", ["size", 1.27, 1.27]], ["hide", "yes"]]],
            ["property", q("Value"), q(name), ["at", 0, val_y, 0],
             ["effects", ["font", ["size", 1.15, 1.15]]]],
        ]
    else:
        out += [
            ["property", q("Reference"), q(s["ref"]), ["at", -hw, hh + 2.54, 0],
             ["effects", ["font", ["size", 1.27, 1.27]], ["justify", "left"]]],
            ["property", q("Value"), q(name), ["at", -hw, -hh - 2.54, 0],
             ["effects", ["font", ["size", 1.27, 1.27]], ["justify", "left"]]],
        ]
    out += [
        ["property", q("Footprint"), q(""), ["at", 0, 0, 0],
         ["effects", ["font", ["size", 1.27, 1.27]], ["hide", "yes"]]],
        ["property", q("Datasheet"), q(""), ["at", 0, 0, 0],
         ["effects", ["font", ["size", 1.27, 1.27]], ["hide", "yes"]]],
    ]
    if s.get("units"):
        for unit_idx, udef in sorted(s["units"].items()):
            ubody = ["symbol", q(f"{name}_{unit_idx}_1")] + list(udef["graphics"])
            for p in udef["pins"]:
                ubody.append(_format_pin_sexp(p))
            out.append(ubody)
    else:
        out.append(["symbol", q(name + "_0_1")] + s["graphics"])
        body = ["symbol", q(name + "_1_1")]
        for p in s["pins"]:
            body.append(_format_pin_sexp(p))
        out.append(body)
    return out


def write_lib(path):
    lib = ["kicad_symbol_lib", ["version", 20241209],
           ["generator", q("kicad_symbol_editor")],
           ["generator_version", q("9.0")]]
    lib += [sym_entry(n, full=False) for n in SYMS]
    with open(path, "w") as fh:
        fh.write(sx(lib) + "\n")


# --------------------------------------------------------------------------
# Canonical netlist map (shared with tools/gen_pcb.py & verified by ERC)
# --------------------------------------------------------------------------
_U1_MAP = {p: "NC" for p in range(1, 74)}
for _gp in (12, 28, 35, 36, 38, 39, 46, 47, 52, 56, 65, 66, 67, 68, 69, 70, 71, 72, 73):
    _U1_MAP[_gp] = "GND"
_U1_MAP.update({
    1: "SWDIO", 2: "SWCLK",
    3: "3V3", 4: "3V3", 55: "3V3",
    6: "VDDA", 7: "VDDA",
    8: "DET_ADC",
    10: "VFBSMPS", 11: "VDDSMPS", 13: "VLXSMPS",
    15: "BAT_SENSE",
    29: "UART_TX", 30: "UART_RX",
    37: "RF_PA",
    43: "BOOT0", 44: "RST",
    50: "BAT_MON_EN",
    51: "DET_EN",
    53: "VDDPA", 54: "VDDRF",
})

NETS = {
    "U1": _U1_MAP,
    "U2": {1: "3V3_DET", 2: "DET_IN", 3: "DET_INN", 4: "GND", 5: "3V3_DET",
           6: "CAPM", 7: "CAPP", 8: "DET_OUT", 9: "GND"},
    "Q1": {1: "VBAT", 2: "GND", 3: "DET_EN", 4: "NC", 5: "3V3_DET", 6: "3V3_DET"},
    "Q2": {1: "GND", 2: "BAT_MON_EN", 3: "VBAT_SW", 4: "VBAT", 5: "VBAT_GATE", 6: "VBAT_GATE"},
    "U3": {1: "VBAT", 2: "GND", 3: "VBAT", 4: "NC", 5: "3V3"},
    "Q3": {1: "GND", 2: "VBAT", 3: "VBAT_RAW"},
    "D_VBAT": {1: "VBAT_RAW", 2: "GND"},
    "D_RST": {1: "RST", 2: "GND"},
    "D_3V3": {1: "3V3", 2: "GND"},
    "D_SWD": {1: "SWDIO", 2: "SWCLK", 3: "GND"},
    "D_UART": {1: "UART_TX", 2: "UART_RX", 3: "GND"},
    "D_RF": {1: "SMA_C", 2: "GND"},
    "J2": {1: "GND", 2: "VBAT_RAW"},
    "J1": {1: "SMA_C", 2: "GND"},
    "J3": {1: "BOOT0", 2: "BOOT_HI"},
    "J4": {1: "VAPP_SENSE", 2: "SWDIO", 3: "SWCLK", 4: "GND", 5: "RST"},
    "J5": {1: "VUART_ISO", 2: "UART_TX", 3: "UART_RX", 4: "GND"},
    "SW1": {1: "RST", 2: "GND"},
    "FB_VDDA": {1: "VDDA", 2: "3V3"},
    "FB_RF": {1: "VDDRF", 2: "3V3"},
    "FB_PA": {1: "VDDPA", 2: "3V3"},
    "FB_SMPS": {1: "3V3", 2: "VDDSMPS"},
    "L_SMPS": {1: "VFBSMPS", 2: "VLXSMPS"},
    "R1": {1: "BR_P", 2: "BR_Q"},
    "R2": {1: "BR_P", 2: "BR_S"},
    "R3": {1: "BR_S", 2: "GND"},
    "R_TERM": {1: "BR_O", 2: "GND"},
    "R_LPF": {1: "DET_OUT", 2: "DET_ADC"},
    "R_PD": {1: "DET_EN", 2: "GND"},
    "R_BPD": {1: "BAT_MON_EN", 2: "GND"},
    "R_BOOT": {1: "BOOT0", 2: "GND"},
    "R_BHI": {1: "BOOT_HI", 2: "3V3"},
    "R_VAPP": {1: "3V3", 2: "VAPP_SENSE"},
    "R_VUART": {1: "VAPP_SENSE", 2: "VUART_ISO"},
    "R_RST": {1: "RST", 2: "3V3"},
    "R_BG": {1: "VBAT", 2: "VBAT_GATE"},
    "R_B1": {1: "VBAT_SW", 2: "BAT_SENSE"},
    "R_B2": {1: "BAT_SENSE", 2: "GND"},
    "R_DIV1": {1: "BR_P", 2: "SMA_C"},
    "R_DIV2": {1: "BR_Q", 2: "SMA_C"},
    "C_RF": {1: "RF_PA", 2: "BR_P"},
    "C_S": {1: "BR_Q", 2: "BR_O"},
    "C_S2": {1: "BR_S", 2: "GND"},
    "C_BLK": {1: "BR_O", 2: "DET_IN"},
    "C_INN": {1: "DET_INN", 2: "GND"},
    "C_CAPP": {1: "CAPP", 2: "3V3_DET"},
    "C_CAPM": {1: "CAPM", 2: "3V3_DET"},
    "C_DET1": {1: "3V3_DET", 2: "GND"},
    "C_DET2": {1: "3V3_DET", 2: "GND"},
    "C_LPF": {1: "DET_ADC", 2: "GND"},
    "C_U1A": {1: "3V3", 2: "GND"},
    "C_U1B": {1: "3V3", 2: "GND"},
    "C_U1C": {1: "3V3", 2: "GND"},
    "C_VBAT": {1: "3V3", 2: "GND"},
    "C_VDDA1": {1: "VDDA", 2: "GND"},
    "C_VDDA2": {1: "VDDA", 2: "GND"},
    "C_VREF": {1: "VDDA", 2: "GND"},
    "C_RFV": {1: "VDDRF", 2: "GND"},
    "C_PAV": {1: "VDDPA", 2: "GND"},
    "C_SMPS1": {1: "VDDSMPS", 2: "GND"},
    "C_SMPS2": {1: "VFBSMPS", 2: "GND"},
    "C_SMPS3": {1: "VFBSMPS", 2: "GND"},
    "C_BULK1": {1: "VBAT", 2: "GND"},
    "C_BULK2": {1: "VBAT", 2: "GND"},
    "C_IN1": {1: "VBAT", 2: "GND"},
    "C_IN2": {1: "VBAT", 2: "GND"},
    "C_Q1": {1: "VBAT", 2: "GND"},
    "C_OUT1": {1: "3V3", 2: "GND"},
    "C_OUT2": {1: "3V3", 2: "GND"},
    "C_BAT": {1: "BAT_SENSE", 2: "GND"},
    "C_RST": {1: "RST", 2: "GND"},
    "C_M1": {1: "BR_Q", 2: "GND"},
    "C_MZ": {1: "BR_Q", 2: "ANT_FEED"},
    "C_M2": {1: "ANT_FEED", 2: "GND"},
    "L_S": {1: "BR_S", 2: "BR_O"},
    "L_Q": {1: "BR_Q", 2: "GND"},
    "L_M1": {1: "BR_Q", 2: "ANT_FEED"},
    "AE1": {1: "ANT_FEED", 2: "GND"},
    "TP1": {1: "3V3"}, "TP2": {1: "3V3_DET"}, "TP3": {1: "VBAT"},
    "TP4": {1: "DET_ADC"}, "TP5": {1: "GND"},
    "H1": {}, "H2": {}, "H3": {}, "H4": {},
    "FID1": {}, "FID2": {}, "FID3": {}, "FID4": {}, "FID5": {},
}

# --------------------------------------------------------------------------
# Component placement table on integer 2.54 mm grid (col, row, rot)
# --------------------------------------------------------------------------
R0402 = "Resistor_SMD:R_0402_1005Metric"
R0402_DNP = "ISAC:R_0402_1005Metric_DNP_NoPaste"
C0402 = "Capacitor_SMD:C_0402_1005Metric"
C0402_DNP = "ISAC:C_0402_1005Metric_DNP_NoPaste"
L0402 = "Inductor_SMD:L_0402_1005Metric"
C0603 = "Capacitor_SMD:C_0603_1608Metric"
C0805 = "Capacitor_SMD:C_0805_2012Metric"
L0805 = "Inductor_SMD:L_0805_2012Metric"
SOD523 = "Diode_SMD:D_SOD-523"
SOD523_DNP = "ISAC:D_SOD-523_DNP_NoPaste"
SOD323 = "Diode_SMD:D_SOD-323"
SOT23 = "Package_TO_SOT_SMD:SOT-23"

# Common verified passive sourcing metadata (MPN, Manufacturer, live-verified LCSC, Alternates)
_CAP_47U_0805_10V = [
    ("MPN", "GRM21BR61A476ME15L"), ("Manufacturer", "Murata"), ("LCSC", "C124129"),
    ("Alternates", "Samsung CL21A476MQYNNNE; Taiyo Yuden LMK212BBJ476MG-T"),
]
_CAP_4U7_0603 = [
    ("MPN", "GRM188R61E475KE11D"), ("Manufacturer", "Murata"), ("LCSC", "C90057"),
    ("Alternates", "Samsung CL10A475KA8NNNC; Taiyo Yuden TMK107BJ475KA-T"),
]
_CAP_4U7_0402_10V = [
    ("MPN", "GRM155R61A475MEAAD"), ("Manufacturer", "Murata"), ("LCSC", "C335105"),
    ("Alternates", "Samsung CL05A475MP5NRNC; Taiyo Yuden LMK105BJ475MV-F"),
]
_CAP_470N_0402_16V = [
    ("MPN", "GRM155R71C474KA01D"), ("Manufacturer", "Murata"), ("LCSC", "C52923"),
    ("Alternates", "Samsung CL05B474KO5NNNC (C1621); Taiyo Yuden TMK105B7474KVHF"),
]
_CAP_100N_0402 = [
    ("MPN", "GRM155R71C104KA88D"), ("Manufacturer", "Murata"), ("LCSC", "C71629"),
    ("Alternates", "Samsung CL05B104KO5NNNC (C1525); Yageo CC0402KRX7R7BB104"),
]
_CAP_1U_0402 = [
    ("MPN", "GRM155R61E105KA12D"), ("Manufacturer", "Murata"), ("LCSC", "C77009"),
    ("Alternates", "Samsung CL05A105KA5NQNC; Taiyo Yuden TMK105BJ105KV-F"),
]
_CAP_1U_0603 = [
    ("MPN", "GRM188R71E105KA12D"), ("Manufacturer", "Murata"), ("LCSC", "C86020"),
    ("Alternates", "Samsung CL10B105KA8NNNC; Yageo CC0603KRX7R8BB105"),
]
_CAP_1N_C0G = [
    ("MPN", "GRM1555C1H102JA01D"), ("Manufacturer", "Murata"), ("LCSC", "C76947"),
    ("Alternates", "Samsung CL05C102JB5NNNC (C1523); Yageo CC0402JRNPO9BN102"),
]
_CAP_100P_HIQ = [
    ("MPN", "GJM1555C1H101JB01D"), ("Manufacturer", "Murata"), ("LCSC", "Authorized: DigiKey/Mouser"),
    ("Alternates", "Murata GRM1555C1H101JA01D; Samsung CL05C101JB5NNNC"),
]
_CAP_1P0_HIQ = [
    ("MPN", "GJM1555C1H1R0WB01D"), ("Manufacturer", "Murata"), ("LCSC", "C161339"),
    ("Alternates", "Murata GRM1555C1H1R0WA01D; Johanson 500R07S1R0AV4T"),
]
_CAP_3P6_HIQ = [
    ("MPN", "GJM1555C1H3R6WB01D"), ("Manufacturer", "Murata"), ("LCSC", "Authorized: DigiKey/Mouser"),
    ("Alternates", "Murata GJM1555C1H3R6BB01D (C94175); Johanson 500R07S3R6BV4T"),
]
_CAP_4P3_HIQ = [
    ("MPN", "GJM1555C1H4R3WB01D"), ("Manufacturer", "Murata"), ("LCSC", "Authorized: DigiKey/Mouser"),
    ("Alternates", "Murata GJM1555C1H4R3BB01D (C94181); Johanson 500R07S4R3BV4T"),
]
_CAP_0P5_HIQ = [
    ("MPN", "GJM1555C1HR50WB01D"), ("Manufacturer", "Murata"), ("LCSC", "Authorized: DigiKey/Mouser"),
    ("Alternates", "Murata GJM1555C1HR50BB01D (C181064); Johanson 500R07SR50BV4T"),
]
_IND_8N2_HIQ = [
    ("MPN", "LQW15AN8N2G00D"), ("Manufacturer", "Murata"), ("LCSC", "Authorized: DigiKey/Mouser"),
    ("Alternates", "Coilcraft 0402CS-8N2XGLW; Taiyo Yuden HKQ1005S8N2S-T"),
]
_FB_120R_0402 = [
    ("MPN", "BLM15AG121SN1D"), ("Manufacturer", "Murata"), ("LCSC", "C85812"),
    ("Alternates", "TDK MMZ1005S121CT000; Taiyo Yuden BK1005HS121-T"),
]
_RES_10K_0402 = [
    ("MPN", "RC0402FR-0710KL"), ("Manufacturer", "Yageo"), ("LCSC", "C60490"),
    ("Alternates", "Uni-Royal 0402WGF1002TCE; Vishay CRCW040210K0FKED"),
]
_RES_1K_0402 = [
    ("MPN", "RC0402FR-071KL"), ("Manufacturer", "Yageo"), ("LCSC", "C106235"),
    ("Alternates", "Uni-Royal 0402WGF1001TCE; Vishay CRCW04021K00FKED"),
]
_RES_0R_0402 = [
    ("MPN", "RC0402JR-070RL"), ("Manufacturer", "Yageo"), ("LCSC", "C60485"),
    ("Alternates", "Uni-Royal 0402WGF0000TCE; Panasonic ERJ-2GE0R00X"),
]
_TVS_SOD323 = [
    ("MPN", "PESD5V0S1BA,115"), ("Manufacturer", "Nexperia"), ("LCSC", "C19224"),
    ("Alternates", "Nexperia PESD5V0L1BA,115 (C15847, I_RM<=50nA, SOD-323 bidir); Bourns CDSOD323-T05C (SOD-323 bidir)"),
]
_TVS_SOT23_DUAL = [
    ("MPN", "PESD5V0U2BT,215"), ("Manufacturer", "Nexperia"), ("LCSC", "Authorized: DigiKey/Mouser"),
    ("Alternates", "Nexperia PESD5V0L2BT,215 (C15855); TI TPD2E009DBZR; ST ESDA6V1L (SOT-23 3-pin 1=IO1,2=IO2,3=GND)"),
]

# Multi-unit sheet coordinates (col, row, rot) for U1A (Unit 1), U1B (Unit 2), U1C (Unit 3)
U1_UNITS = {
    1: (31, 68, 0),   # U1A: Power, Isolated VDDA/VDDRF/VDDPA & 15 uH SMPS
    2: (41, 33, 0),   # U1B: MCU Control, Protected Debug, ADC & Sub-GHz RF_OUT
    3: (19, 100, 0),  # U1C: Unused LGA-73 GPIO & Internal NC Bank
}

# (ref, lib, value, footprint, col, row, rot, dnp, fields)
PARTS = [
    # ---- 1 & 2 & 3. RAK3172LP-SiP (LGA-73 Multi-Unit U1A/U1B/U1C)
    ("U1", "RAK3172LP-SiP", "RAK3172LP-SiP",
     "ISAC:RAK3172LP-SiP_LGA-73_12x12mm_P0.6mm", U1_UNITS[1][0], U1_UNITS[1][1], 0, False,
     [("MPN", "RAK3172LP-SIP-8-SM-NI"), ("Manufacturer", "RAKwireless"),
      ("LCSC", "Authorized: RAKwireless/Mouser/DigiKey"),
      ("Alternates", "NO SUBSTITUTION -- Authorized RAKwireless SKU 305049 / Mouser 910-RAK3172LPSIP8SMN / DigiKey ONLY (EU868 RFO_LP LGA-73; DO NOT substitute RAK3172-SiP RFO_HP)")]),

    # VDD1 / VDD2 / VBAT digital 3V3 bypass bank (Frame 2, left of U1A)
    ("C_U1A", "C", "4.7u", C0603, 6, 60, 270, False, _CAP_4U7_0603),
    ("C_U1B", "C", "100n", C0402, 11, 60, 270, False, _CAP_100N_0402),
    ("C_U1C", "C", "100n", C0402, 15, 60, 270, False, _CAP_100N_0402),
    ("C_VBAT", "C", "1u", C0402, 20, 60, 270, False, _CAP_1U_0402),

    # Ferrite-isolated Analog Reference rail (Frame 2, top-right of U1A)
    ("FB_VDDA", "FB", "120R@100M", L0402, 52, 60, 0, False, _FB_120R_0402),
    ("C_VDDA1", "C", "4.7u", C0603, 40, 63, 270, False, _CAP_4U7_0603),
    ("C_VDDA2", "C", "1u", C0402, 45, 63, 270, False, _CAP_1U_0402),
    ("C_VREF", "C", "100n", C0402, 50, 63, 270, False, _CAP_100N_0402),

    # Ferrite-isolated RF & PA power rails (Frame 2, mid/bottom-right of U1A)
    ("FB_RF", "FB", "120R@100M", L0402, 50, 69, 0, False, _FB_120R_0402),
    ("C_RFV", "C", "1u", C0402, 44, 71, 270, False, _CAP_1U_0402),
    ("FB_PA", "FB", "120R@100M", L0402, 50, 77, 0, False, _FB_120R_0402),
    ("C_PAV", "C", "1u", C0402, 44, 79, 270, False, _CAP_1U_0402),

    # Reset network + IEC 61000-4-2 ESD clamp (Frame 1, top-left of U1B)
    ("R_RST", "R", "10k", R0402, 29, 11, 90, False, _RES_10K_0402),
    ("C_RST", "C", "100n", C0402, 23, 15, 270, False, _CAP_100N_0402),
    ("D_RST", "TVS_BIDIR", "PESD5V0S1BA", SOD323, 16, 15, 270, False, _TVS_SOD323),
    ("SW1", "SW_PUSH", "RESET", "Button_Switch_SMD:SW_SPST_B3U-1000P", 9, 15, 270, False,
     [("MPN", "B3U-1000P"), ("Manufacturer", "Omron"), ("LCSC", "C231329"),
      ("Alternates", "Omron B3U-1000P-B (exact 3.0x2.5mm 2-pad SPST SMD land pattern)")]),

    # BOOT0, SWD & UART2 interfaces (Frame 1, left of U1B)
    ("R_BOOT", "R", "10k", R0402, 27, 26, 270, False, _RES_10K_0402),
    ("R_BHI", "R", "10k", R0402, 20, 27, 0, False, _RES_10K_0402),
    ("J3", "Conn_01x02", "DNP BOOT", "Connector_PinHeader_2.54mm:PinHeader_1x02_P2.54mm_Vertical",
     11, 25, 0, True,
     [("MPN", "PZ254V-11-02P"), ("Manufacturer", "XFCN"), ("LCSC", "C492401"),
      ("Alternates", "Wurth 61300211121; Amphenol 68000-102HLF (DNP on sealed field SKU -- bare ENIG pogo-pin pads)")]),
    ("R_VAPP", "R", "1k", R0402, 21, 30, 180, False, _RES_1K_0402),
    ("J4", "Conn_01x05", "DNP SWD", "Connector_PinHeader_2.54mm:PinHeader_1x05_P2.54mm_Vertical",
     11, 32, 0, True,
     [("MPN", "PZ254V-11-05P"), ("Manufacturer", "XFCN"), ("LCSC", "C492404"),
      ("Alternates", "Wurth 61300511121; Amphenol 68000-105HLF (DNP on sealed field SKU -- bare ENIG pogo-pin pads)")]),
    ("D_SWD", "PESD5V0U2BT", "PESD5V0U2BT", SOT23, 26, 33, 0, False, _TVS_SOT23_DUAL),
    ("R_VUART", "R", "DNP 0R", R0402_DNP, 21, 41, 180, True, _RES_0R_0402),
    ("J5", "Conn_01x04", "DNP UART", "Connector_PinHeader_2.54mm:PinHeader_1x04_P2.54mm_Vertical",
     11, 43, 0, True,
     [("MPN", "PZ254V-11-04P"), ("Manufacturer", "XFCN"), ("LCSC", "C492403"),
      ("Alternates", "Wurth 61300411121; Amphenol 68000-104HLF (DNP on sealed field SKU -- bare ENIG pogo-pin pads)")]),
    ("D_UART", "PESD5V0U2BT", "PESD5V0U2BT", SOT23, 26, 44, 0, False, _TVS_SOT23_DUAL),

    # Internal DC-DC SMPS buck converter (Frame 2, lower-left of U1A)
    ("FB_SMPS", "R", "0R", R0402, 11, 68, 0, False, _RES_0R_0402),
    ("C_SMPS1", "C", "4.7u", C0402, 15, 70, 270, False, _CAP_4U7_0402_10V),
    ("L_SMPS", "L", "15u", L0805, 16, 75, 0, False,
     [("MPN", "LQH2MCN150K02L"), ("Manufacturer", "Murata"), ("LCSC", "C86089"),
      ("Alternates", "Murata LQM21PN150MGH (0805 15uH power inductor, Isat=300mA); TDK VLS201610HBX-150M-1 -- NEVER substitute ferrite EMI beads (MLZ2012)")]),
    ("C_SMPS2", "C", "470n", C0402, 8, 80, 270, False, _CAP_470N_0402_16V),
    ("C_SMPS3", "C", "DNP 100n", C0402_DNP, 14, 80, 270, True, _CAP_100N_0402),

    # ---- 4. Return-Loss Bridge & VNA Calibration Diverter ----------------
    ("C_RF", "C", "100p", C0402, 62, 22, 0, False, _CAP_100P_HIQ),
    ("R1", "R", "8.2 (0.1%)", R0402, 76, 22, 0, False,
     [("MPN", "RT0402BRD078R2L"), ("Manufacturer", "Yageo"), ("LCSC", "Authorized: DigiKey/Mouser"),
      ("Alternates", "Yageo RT0402DRD078R2L (±0.5%); Panasonic ERA-2AED8R2X (±0.5%)")]),
    ("R2", "R", "681 (0.1%)", R0402, 71, 29, 270, False,
     [("MPN", "RG1005P-6810-B-T5"), ("Manufacturer", "Susumu"), ("LCSC", "Authorized: DigiKey/Mouser"),
      ("Alternates", "Vishay TNPW0402681RBEED; Yageo RT0402BRD07681RL")]),
    ("R3", "R", "3.57k (0.1%)", R0402, 71, 48, 270, False,
     [("MPN", "RG1005P-3571-B-T5"), ("Manufacturer", "Susumu"), ("LCSC", "Authorized: DigiKey/Mouser"),
      ("Alternates", "Vishay TNPW04023K57BEED; Yageo RT0402BRD073K57L")]),
    ("C_S2", "C", "1.0p", C0402, 79, 48, 270, False, _CAP_1P0_HIQ),
    ("L_Q", "L", "27n", L0402, 89, 27, 270, False,
     [("MPN", "LQW15AN27NG00D"), ("Manufacturer", "Murata"), ("LCSC", "Authorized: DigiKey/Mouser"),
      ("Alternates", "Coilcraft 0402CS-27NXGLW; Murata LQW15AN27NG80D")]),
    ("C_S", "C", "1.0p", C0402, 96, 32, 270, False, _CAP_1P0_HIQ),
    ("L_S", "L", "30n", L0402, 87, 44, 0, False,
     [("MPN", "LQW15AN30NG00D"), ("Manufacturer", "Murata"), ("LCSC", "Authorized: DigiKey/Mouser"),
      ("Alternates", "Coilcraft 0402CS-30NXGLW; Murata LQW15AN30NG80D")]),
    ("R_TERM", "R", "56 (0.1%)", R0402, 103, 48, 270, False,
     [("MPN", "RG1005P-560-B-T5"), ("Manufacturer", "Susumu"), ("LCSC", "Authorized: DigiKey/Mouser"),
      ("Alternates", "Vishay TNPW040256R0BEED; Yageo RT0402BRD0756RL")]),

    ("R_DIV1", "R", "DNP 0R", R0402_DNP, 67, 16, 90, True, _RES_0R_0402),
    ("R_DIV2", "R", "DNP 0R", R0402_DNP, 83, 16, 90, True, _RES_0R_0402),
    ("D_RF", "TVS_BIDIR", "DNP", SOD523_DNP, 92, 16, 270, True,
     [("MPN", "ESD9B5.0ST5G"), ("Manufacturer", "onsemi"), ("LCSC", "Authorized: DigiKey/Mouser"),
      ("Alternates", "Nexperia PESD5V0U1BB,115 (C85364); Vishay VESD05A1B-HAF-GS08 (SOD-523 ultra-low Cd=0.5pF RF ESD)")]),
    ("J1", "SMA", "DNP SMA_VNA", "ISAC:SMA_Molex_73251-1153_EdgeMount_Horizontal_HandSolder",
     102, 14, 0, True,
     [("MPN", "73251-1153"), ("Manufacturer", "Molex"), ("LCSC", "Authorized: Mouser/DigiKey"),
      ("Alternates", "NO SUBSTITUTION -- Molex 73251-1153 (1.60mm PCB edge-straddle SMA jack; DNP on enclosed field SKU, post-reflow hand-solder on bench VNA units) ONLY")]),

    # ---- 5. Elliptic Low-Pass Harmonic Pi-Filter & Printed Folded IFA ----
    ("C_M1", "C", "3.6p", C0402, 118, 25, 270, False, _CAP_3P6_HIQ),
    ("L_M1", "L", "8.2n", L0402, 127, 22, 0, False, _IND_8N2_HIQ),
    ("C_MZ", "C", "0.5p", C0402, 127, 15, 0, False, _CAP_0P5_HIQ),
    ("C_M2", "C", "4.3p", C0402, 136, 25, 270, False, _CAP_4P3_HIQ),
    ("AE1", "IFA", "IFA_868MHz_ISAC", "ISAC:IFA_868MHz_ISAC_40x20mm", 150, 23, 0, False,
     [("MPN", "PCB trace"), ("Manufacturer", "Custom")]),

    # ---- 6. LT5538 Log Detector & Anti-Aliasing Video LPF ----------------
    ("C_BLK", "C", "100p", C0402, 115, 44, 0, False, _CAP_100P_HIQ),
    ("U2", "LT5538IDD", "LT5538IDD#TRPBF",
     "ISAC:LT5538IDD_DFN-8-1EP_3x3mm_P0.5mm_EP1.65x2.38mm", 129, 45, 0, False,
     [("MPN", "LT5538IDD#TRPBF"), ("Manufacturer", "Analog Devices"), ("LCSC", "Authorized: DigiKey/Mouser"),
      ("Alternates", "NO SUBSTITUTION -- Analog Devices LT5538IDD#TRPBF (8mm T&R, Mouser 584-LT5538IDD#TRPBF / DigiKey LT5538IDD#TRPBFCT-ND); LT5538IDD#PBF (37-pc tube, LCSC C580201 -- requires custom tube feeder)")]),
    ("C_INN", "C", "1n", C0402, 119, 50, 270, False, _CAP_1N_C0G),
    ("C_CAPP", "C", "1n", C0402, 139, 40, 90, False, _CAP_1N_C0G),
    ("C_CAPM", "C", "1n", C0402, 145, 40, 90, False, _CAP_1N_C0G),
    ("R_LPF", "R", "1k", R0402, 146, 47, 0, False, _RES_1K_0402),
    ("C_LPF", "C", "100n", C0402, 151, 50, 270, False, _CAP_100N_0402),

    # ---- 7. 1S Battery Input, Ideal Diode, Gated VBAT Sense, LDO & 3V3_DET
    ("J2", "Conn_01x02", "DNP 1S_BATT",
     "Connector_JST:JST_PH_B2B-PH-K_1x02_P2.00mm_Vertical",
     65, 71, 0, True,
     [("MPN", "B2B-PH-K-S"), ("Manufacturer", "JST"), ("LCSC", "C131337"),
      ("Alternates", "DNP on sealed field SKU -- solder 24-26 AWG silicone battery leads directly to bare ENIG PTH pads (Pad1 Square=BLACK GND, Pad2 Round=RED +VBAT_RAW); JST B2B-PH-K-S(LF)(SN) (LCSC C54911) optional for bench builds")]),
    ("D_VBAT", "TVS_BIDIR", "PESD5V0S1BA", SOD323, 71, 74, 270, False, _TVS_SOD323),
    ("Q3", "PMOS_RPP", "AO3401A", SOT23, 78, 70, 0, False,
     [("MPN", "AO3401A"), ("Manufacturer", "Alpha & Omega"), ("LCSC", "C15127"),
      ("Alternates", "Nexperia PMV48XP,215 (C15137); Infineon IRLML6402TRPBF (C2590); Vishay SI2301CDS-T1-GE3 (C10487)")]),
    ("R_BG", "R", "470k", R0402, 86, 73, 270, False,
     [("MPN", "RC0402FR-07470KL"), ("Manufacturer", "Yageo"), ("LCSC", "C482181"),
      ("Alternates", "Uni-Royal 0402WGF4703TCE; Vishay CRCW0402470KFKED")]),
    ("Q2", "NX3008CBKS", "NX3008CBKS", "Package_TO_SOT_SMD:SOT-363_SC-70-6",
     95, 72, 0, False,
     [("MPN", "NX3008CBKS,115"), ("Manufacturer", "Nexperia"), ("LCSC", "C456076"),
      ("Alternates", "NO SUBSTITUTION -- Nexperia NX3008CBKS,115 (SOT-363 complementary N+P MOSFET, 1=S1,2=G1,3=D2,4=S2,5=G2,6=D1) ONLY")]),
    ("R_BPD", "R", "100k", R0402, 108, 73, 270, False,
     [("MPN", "RC0402FR-07100KL"), ("Manufacturer", "Yageo"), ("LCSC", "C60491"),
      ("Alternates", "Uni-Royal 0402WGF1003TCE; Vishay CRCW0402100KFKED")]),
    ("R_B1", "R", "4.7k (0.1%)", R0402, 102, 82, 270, False,
     [("MPN", "RG1005P-472-B-T5"), ("Manufacturer", "Susumu"), ("LCSC", "Authorized: DigiKey/Mouser"),
      ("Alternates", "Vishay TNPW04024K70BEED; Yageo RT0402BRD074K7L")]),
    ("R_B2", "R", "4.7k (0.1%)", R0402, 102, 89, 270, False,
     [("MPN", "RG1005P-472-B-T5"), ("Manufacturer", "Susumu"), ("LCSC", "Authorized: DigiKey/Mouser"),
      ("Alternates", "Vishay TNPW04024K70BEED; Yageo RT0402BRD074K7L")]),
    ("C_BAT", "C", "1n", C0402, 109, 89, 270, False, _CAP_1N_C0G),

    ("C_BULK1", "C", "47u", C0805, 115, 70, 270, False, _CAP_47U_0805_10V),
    ("C_BULK2", "C", "47u", C0805, 120, 70, 270, False, _CAP_47U_0805_10V),
    ("C_IN1", "C", "10u", C0603, 125, 70, 270, False,
     [("MPN", "GRM188R61E106MA73D"), ("Manufacturer", "Murata"), ("LCSC", "C91606"),
      ("Alternates", "Samsung CL10A106MA8NRNC; Murata GRM188R61E106KA73D")]),
    ("C_IN2", "C", "100n", C0402, 130, 70, 270, False, _CAP_100N_0402),
    ("U3", "TPS7A0233DBVR", "TPS7A0233DBVR", "Package_TO_SOT_SMD:SOT-23-5", 138, 69, 0, False,
     [("MPN", "TPS7A0233DBVR"), ("Manufacturer", "Texas Instruments"), ("LCSC", "C2873330"),
      ("Alternates", "NO SUBSTITUTION -- TI TPS7A0233DBVR (SOT-23-5 DBV pinout 1=IN,2=GND,3=EN,4=NC,5=OUT, Iq=25nA) ONLY")]),
    ("C_OUT1", "C", "1u", C0603, 143, 70, 270, False, _CAP_1U_0603),
    ("C_OUT2", "C", "100n", C0402, 148, 70, 270, False, _CAP_100N_0402),
    ("D_3V3", "TVS_BIDIR", "PESD5V0S1BA", SOD323, 153, 70, 270, False, _TVS_SOD323),

    ("Q1", "TPS22919DCKR", "TPS22919DCKR", "Package_TO_SOT_SMD:SOT-363_SC-70-6",
     137, 86, 0, False,
     [("MPN", "TPS22919DCKR"), ("Manufacturer", "Texas Instruments"), ("LCSC", "Authorized: DigiKey/Mouser"),
      ("Alternates", "NO SUBSTITUTION -- TI TPS22919DCKR / TPS22919QDCKRQ1 (SC-70-6 DCK pinout 1=VIN,2=GND,3=ON,4=NC,5=QOD,6=VOUT) ONLY")]),
    ("C_Q1", "C", "100n", C0402, 117, 87, 270, False, _CAP_100N_0402),
    ("R_PD", "R", "100k", R0402, 128, 90, 270, False,
     [("MPN", "RC0402FR-07100KL"), ("Manufacturer", "Yageo"), ("LCSC", "C60491"),
      ("Alternates", "Uni-Royal 0402WGF1003TCE; Vishay CRCW0402100KFKED")]),
    ("C_DET1", "C", "100n", C0402, 145, 87, 270, False, _CAP_100N_0402),
    ("C_DET2", "C", "1u", C0603, 150, 87, 270, False, _CAP_1U_0603),

    # ---- 8. Clean DC/Low-Speed Test Points ONLY (ZERO RF Test Points) ----
    ("TP1", "TP", "3V3", "TestPoint:TestPoint_Pad_D1.5mm", 158, 66, 0, False, []),
    ("TP2", "TP", "3V3_DET", "TestPoint:TestPoint_Pad_D1.5mm", 155, 83, 0, False, []),
    ("TP3", "TP", "VBAT", "TestPoint:TestPoint_Pad_D1.5mm", 112, 66, 0, False, []),
    ("TP4", "TP", "DET_ADC", "TestPoint:TestPoint_Pad_D1.5mm", 151, 46, 0, False, []),
    ("TP5", "TP", "GND", "TestPoint:TestPoint_Pad_D1.5mm", 158, 73, 0, False, []),

    # ---- 9. Mechanical Mounting Holes & Global SMT Fiducials (Frame 3) ---
    ("H1", "MOUNT", "M2.5", "MountingHole:MountingHole_2.7mm_M2.5", 35, 95, 0, False, []),
    ("H2", "MOUNT", "M2.5", "MountingHole:MountingHole_2.7mm_M2.5", 40, 95, 0, False, []),
    ("H3", "MOUNT", "M2.5", "MountingHole:MountingHole_2.7mm_M2.5", 45, 95, 0, False, []),
    ("H4", "MOUNT", "M2.5", "MountingHole:MountingHole_2.7mm_M2.5", 50, 95, 0, False, []),
    ("FID1", "FID", "Fid_G1", "Fiducial:Fiducial_1mm_Mask2mm", 34, 105, 0, False, []),
    ("FID2", "FID", "Fid_G2", "Fiducial:Fiducial_1mm_Mask2mm", 39, 105, 0, False, []),
    ("FID3", "FID", "Fid_G3", "Fiducial:Fiducial_1mm_Mask2mm", 44, 105, 0, False, []),
    ("FID4", "FID", "Fid_U1A", "Fiducial:Fiducial_1mm_Mask2mm", 49, 105, 0, False, []),
    ("FID5", "FID", "Fid_U1B", "Fiducial:Fiducial_1mm_Mask2mm", 53, 105, 0, False, []),
]

PART_MAP = {p[0]: p for p in PARTS}

assert set(PART_MAP.keys()) == set(NETS.keys()), "PARTS vs NETS key mismatch!"
for _ref, _pmap in NETS.items():
    _lib = PART_MAP[_ref][1]
    _expected_pins = {p["num"] for p in SYMS[_lib]["pins"]}
    assert set(_pmap.keys()) == _expected_pins, f"{_ref} ({_lib}) pin map mismatch!"


def pin_grid(ref, pnum):
    """Return exact integer (col, row) of component pin on schematic sheet."""
    _, lib, _, _, cx, cy, rot, _, _ = PART_MAP[ref]
    for p in SYMS[lib]["pins"]:
        if str(p["num"]) == str(pnum):
            if ref == "U1":
                cx, cy, rot = U1_UNITS[p["unit"]]
            gx = round(p["lx"] / G)
            gy = round(p["ly"] / G)
            if rot == 0:
                return (cx + gx, cy - gy)
            if rot == 90:
                return (cx - gy, cy - gx)
            if rot == 180:
                return (cx - gx, cy + gy)
            if rot == 270:
                return (cx + gy, cy + gx)
            raise ValueError(rot)
    raise KeyError(f"{ref} pin {pnum}")


# Explicit human-tuned (ref_dx, ref_dy, ref_just, val_dx, val_dy, val_just) overrides (mm)
PROP_OVERRIDES = {
    "D_RST":   (1.5, -0.9, "left", 1.5, 0.9, "left"),
    "R_RST":   (1.5, -0.9, "left", 1.5, 0.9, "left"),
    "FB_VDDA": (0.0, -2.5, "center", 0.0, 2.6, "center"),
    "FB_RF":   (0.0, -2.5, "center", 0.0, 2.6, "center"),
    "FB_PA":   (0.0, -2.5, "center", 0.0, 2.6, "center"),
    "R_B1":    (1.5, -0.9, "left", 1.5, 0.9, "left"),
    "R_B2":    (-1.5, -0.9, "right", -1.5, 0.9, "right"),
    "Q3":      (0.0, -4.4, "center", 3.2, 2.2, "left"),
}
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
