abbottsteve/LoRaWAN-ISAC-868MHz/tools/check_doc_parity.py

#!/usr/bin/env python3
"""
Documentation-to-Hardware, Link & MathML Parity Verifier (`Rev E.5`)
====================================================================
Prevents silent documentation, link, MathML, or simulation drift across the
two-tier open-hardware documentation graph by cross-checking:
  - `README.md` (executive scientific landing page, <= 280 lines)
  - `docs/ISAC_868MHz_System_Design_and_Operation_Summary.md` & `.pdf`
  - `docs/rf_design_and_simulation.md`
  - `docs/firmware_and_pinmap.md` (`U1` LGA-73 pinout & `FPort = 10` payload)
  - `docs/bom_and_enclosure.md` (46-line Turnkey BOM & `TP1..TP5`)
  - `docs/power_budget.md` & `docs/rf_link_budget.md`
  - `docs/bringup_report.md` (`5–10` board pilot bring-up & sign-off checklist)
  - `cst_studio/README.md` & `CITATION.cff`
  - `fab/documentation/PCBWAY_TURNKEY_FABRICATION_SPECIFICATION.md` & `fab/cpl/CPL_README.md`
  - `docs/*` visual inspection PDFs/PNGs
against live ground truth extracted from:
  - `rf/results/ifa_fullwave_3d.json` & `rf/results/bridge_3tone_curves.json` (<= 0.01 dB / 0.00 MHz)
  - `firmware/test/data/design_values.json`
  - `ISAC_868_KiCad9.kicad_pcb`
  - `firmware/include/isac_board_pins.h` & `firmware/include/isac_sensing.h`
  - `fab/ISAC_868_RevE5_PCBWay_Turnkey.zip`
"""

import csv
import io
import json
import os
import re
import subprocess
import sys
import zipfile

import pcbnew

ROOT = os.path.abspath(os.path.join(os.path.dirname(__file__), ".."))
DOCS_DIR = os.path.join(ROOT, "docs")

SUMMARY_MD = os.path.join(DOCS_DIR, "ISAC_868MHz_System_Design_and_Operation_Summary.md")
SUMMARY_PDF = os.path.join(DOCS_DIR, "ISAC_868MHz_System_Design_and_Operation_Summary.pdf")
README_MD = os.path.join(ROOT, "README.md")
RF_SIM_MD = os.path.join(DOCS_DIR, "rf_design_and_simulation.md")
FW_PIN_MD = os.path.join(DOCS_DIR, "firmware_and_pinmap.md")
BOM_ENC_MD = os.path.join(DOCS_DIR, "bom_and_enclosure.md")
POWER_MD = os.path.join(DOCS_DIR, "power_budget.md")
LINK_BUDGET_MD = os.path.join(DOCS_DIR, "rf_link_budget.md")
BRINGUP_MD = os.path.join(DOCS_DIR, "bringup_report.md")
OPEN_ITEMS_MD = os.path.join(DOCS_DIR, "OPEN_ITEMS.md")
CST_MD = os.path.join(ROOT, "cst_studio", "README.md")
CITATION_CFF = os.path.join(ROOT, "CITATION.cff")
TURNKEY_SPEC_MD = os.path.join(ROOT, "fab", "documentation", "PCBWAY_TURNKEY_FABRICATION_SPECIFICATION.md")
CPL_README_MD = os.path.join(ROOT, "fab", "cpl", "CPL_README.md")

DESIGN_JSON = os.path.join(ROOT, "firmware", "test", "data", "design_values.json")
IFA_JSON = os.path.join(ROOT, "rf", "results", "ifa_fullwave_3d.json")
BR_JSON = os.path.join(ROOT, "rf", "results", "bridge_3tone_curves.json")
PCB_PATH = os.path.join(ROOT, "ISAC_868_KiCad9.kicad_pcb")
ZIP_PATH = os.path.join(ROOT, "fab", "ISAC_868_RevE5_PCBWay_Turnkey.zip")
FW_PINS_H = os.path.join(ROOT, "firmware", "include", "isac_board_pins.h")
FW_SENSING_H = os.path.join(ROOT, "firmware", "include", "isac_sensing.h")

BANNED_LEGACY_TOKENS = (
    "Rev C.0",
    "Revision C.0",
    "Rev D.0",
    "Revision D.0",
    "Rev E.0",
    "Revision E.0",
    "Rev E.1",
    "Revision E.1",
    "Rev E.2",
    "Revision E.2",
    "Rev E.3",
    "Revision E.3",
    "Rev E.4",
    "Revision E.4",
    "RevE0_Frame",
    "ISAC_868_RevE0_PCBWay_Turnkey.zip",
    "ISAC_868_RevE1_PCBWay_Turnkey.zip",
    "ISAC_868_RevE2_PCBWay_Turnkey.zip",
    "ISAC_868_RevE3_PCBWay_Turnkey.zip",
    "ISAC_868_RevE4_PCBWay_Turnkey.zip",
    "MLZ2012M150WT000",
    "RG1005P-8R2-B-T5",
    "TNPW04028R20BEED",
    "ERA-2AEB8R2X",
    "C2906778",
    "C80043",
    "C86104",
    "C135303",
    "C496550",
    "51.1R",
    "\u00fe\u00ff",
    "../analysis",
    "B5819W",
    "RAK3172-E",
    "STM32WLE5CC",
    "AP2112K",
    "v_f2_mv",
    "vbat_20mv",
)

REQUIRED_DOCS_VISUALS = (
    "ISAC_868_Schematic.pdf",
    "ISAC_868_PCB_Top_Sheet.pdf",
    "ISAC_868_PCB_Bottom_Sheet.pdf",
    "ISAC_868_Assembly_Top.pdf",
    "ISAC_868_3D_Top.png",
    "ISAC_868_3D_Bottom.png",
    "ISAC_868_3D_Iso.png",
    "ISAC_868_3D_Iso_Rear.png",
    "ISAC_868_Enclosure_0p80mm_Blueprint.png",
    "ISAC_868_Enclosure_Battery_Blueprint.png",
    "ISAC_868_Enclosure_3D_Exploded.png",
)


def _split_refs(s):
    return sorted(tok.strip(" `*") for tok in re.split(r"[,;\s]+", s.strip(" `*")) if tok.strip(" `*"))
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
