abbottsteve/LoRaWAN-ISAC-868MHz/(commit log)

2026-11-07 feat(reve5): Dual-Function 868 MHz LoRaWAN ISAC Antenna-Sensor (Rev E.5)
    [B1_u1_pad_verification.csv, ISAC_868_Base_Tray.stl, ISAC_868_Base_Tray_Battery.stl, ISAC_868_Bench_THT_HandSolder.csv, ISAC_868_Enclosure_0p80mm.scad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]
2026-11-07 docs(reve5): refine technical documentation and add Apache-2.0 licensing
    - Add Apache License 2.0 (LICENSE) and CITATION.cff attributed to Stephen K. Boachie.
    - Rewrite README.md, system design summary (MD + PDF), power/RF link budgets,
    pilot bring-up guide, open bench measurement tracker, and turnkey assembly notes
    with clear hardware status, design trade-offs, and Rev F.0 roadmap.
    - Rename tools/audit_cross_check_e2.py -> tools/verify_design_consistency.py and
    regenerate clean U1 LGA-73 footprint verification reports under docs/reports/.
    - Clean internal review tags across C11 firmware headers/sources, EM solvers,
    enclosure generator, and verification scripts while keeping frozen R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
    [u1_pad_verification.csv]
2026-11-07 Add CST Studio Suite 3D full-wave antenna, enclosure & Debye superstrate simulation package
    - Add parameterized CST Microwave Studio 3D FIT model (ISAC_868_Complete_Antenna_MWS.bas, 0.70-3.00 GHz, -45 dB accuracy) extracted directly from frozen Rev E.5 KiCad PCB and footprint polygons
    - Model IPC-4552 ENIG surface impedance (Rs = 23.74 mOhm/sq @ 868 MHz), 1.51 mm FR-4 core, bare-ENIG IDE window, conformal 25 um 3M 467MP trench fill, 0.80 mm ASA/PETG open-East radome, EPDM O-ring, fasteners, and battery options
    - Add causal 1st-order Debye dispersive models for Water and IPA, dual port excitation modes (/BR_Q + 3D 0402 C_M1/L_M1/C_MZ/C_M2 matching network vs direct AE1 Pad 1), and local hexah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
    [AE1_and_Filter_F_Cu.dxf, Bare_ENIG_Window_F_Mask.dxf, Counterpoise_B_Cu.dxf, PCB_Outline_EdgeCuts.dxf, cst_vs_fdtd_comparison.csv]
2026-11-08 docs(reve5): refine academic signal model, de-embed CST post-processing, and clean prose typography
    - De-embed elliptic Pi-filter (C_M1, L_M1 || C_MZ, C_M2) in cst_studio/python/postprocess_cst_results.py so --mode 1 extracts standalone AE1 f0 (43.73 MHz/RIU Air-to-Ice sensitivity) and relabel --verify-pipeline output as fdtd_touchstone_selfcheck.{md,csv}
    - Report both AE1 feed (|Gamma_ant|) and Pi-filter-cascaded /BR_Q (|Gamma_in|) reflection reference planes across README, Summary datasheet, link budget, and CST documentation
    - Add analytical 3-port reflectometer + ratiometric VREFINT formulation, physical sensing boundary conditions (film-thickness degeneracy, narrowband skirt compression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
    [cst_vs_fdtd_comparison.csv, fdtd_touchstone_selfcheck.csv]
2026-11-08 docs(reve5): fix GitHub MathML equations, Mermaid clipping, full-width figures, and BOM table wrapping
    [render_summary_pdf.py]
2026-11-08 docs(reve5): fix 3-sigma inline math delimiter in rf_design_and_simulation.md
    [check_doc_parity.py]
